dhansel/ArduinoFDC/(threads)

Thread 1 (2021-04-06):

Extension for HD possible?

Scotty42, 2021-04-06:
I was wondering if hardcoded gaps, sectors, etc or the required data rate of 500 kbit vs. 250 kbit is the actual limiting factor that blocks high density (1,2 MB + 1,44 MB) support?

dhansel, 2021-04-13:
The limiting factor is the data rate. At 500 kbit, a new data bit
arrives from the drive every 2 microseconds. At 16MHz clock frequency
that's only 32 processor cycles. The current read/write implementation
in C using timers is not fast enough for that.

I am considering rewriting the read/write code in assembly which
would make it possible ensure correct timing by adding up the processor
cycles needed for each instruction. That should be fast enough.

Scotty42, 2021-04-13:
Was expecting this. Thanks for clarification.

dhansel, 2021-04-18:
As expected, re-writing the read/write routines in assembly solved the timing issues
for HD disks. Timing is close but works as far as I can tell from my testing.

The controller now supports 3.5" and 5.25" DD and HD disks.

Scotty42, 2021-04-19:
That's awesome! I'll do some tests and report back.

Scotty42, 2021-04-20:
Did connect 3,5" HD as A and 5,25" HD as B on a standard floppy cable with twist on A. Host end of the cable connected to some pinheaders and an Arduino Uno board. Although I can verify Arduino pins are connected to the floppy ports according to README table, I fail to read/write/format anything. I can select s 0/1 and turn motor 0/1. Any other operations start motors, light up LEDs but nothing actually happens. Head does not step. Do you have any idea to further analyze and debug?

dhansel, 2021-04-21:
I just tried it again here, uploaded the code from GIT to the Arduino and re-connected my drive
following the wiring from the instructions. Works fine for me in that configuration (tested two different
drives). So at least the wiring/code is not completely broken :)

Do you get any error message when trying to read a sector ("r 0 1")? If so, what is the error number?
If not, does the disk LED come on when trying to read? Does it stay on and the process just hangs
or does the LED go off again? Is there any out in the terminal? try un-commenting the "#define DEBUG"
statement in ArduinoFDC.cpp and uploading again. Does that show any more information?

Try and add the following code at the end of the AduinoFDCClass::begin() function in ArduinoFDC.cpp:
```
  digitalWriteOC(PIN_SELECTA, LOW);
  step_to_track0();
  step_tracks(m_driveType[0], 20);
  step_to_track0();
  digitalWriteOC(PIN_SELECTA, HIGH);

```
After uploading you should hear the drive head step (to track 0, then track 20, then back to 0).
If that does not happen then most likely something is wrong with the wiring. Maybe the GND
signal is not properly connected? I've seen drives/cables where not all odd-numbered pins are
actually connected to ground.

Generally the code is not supposed to hang. Even with no drive connected at all it should at least
display an error message. If the code is hanging when reading, try putting a `return S_OK;`
statement at the beginning of function "read_data" in ArduinoFDC.cpp
That will skip all read attempts completely. Does that still hang? If not then that may indicate
that the code is getting stuck in the assembly section(s).

Scotty42, 2021-04-21:
I wasn't doubting your tests :). Really appreciate above tipps 👍
As almost always after reaching out to someone, problem solves itself. No, not on itself, but I can trace it back to a faulty head DIR line in the cable and some weird behavior with GND connections. I had:

- all connected
- one
- two as Arduino Uno offers 2 GND pins

And after randomly (re)selecting 2 GND pins finally a 3,5" Floppy was accessible. Haven't yet tried 5,25" again, but I'd say it is save to assume it will work now, too.

dhansel, 2021-04-21:
Glad to hear it's working! When trying the 5.25" drive make sure to set the correct drive type, either by changing
the parameters to the ArduinoFDC.begin() function or by using the 't' command.

Scotty42, 2021-04-21:
I can confirm 5,25" HD drive working with HD floppy and mode t2.
I fail to r/w/f a DD floppy though. r/w yields error No sync marks found! and f leads to some undefined operation for minutes that ends without error but does not do anything.

dhansel, 2021-04-21:
Does the head step while trying to format the DD disk The format process does not read anything back to see whether the format worked. It just formats a track and moves on to the next. So 'f' returning OK doesn't really mean much.

I assume you mean you're having problems with a 5.25" DD disk. Which disk type are you setting? Since you have a 5.25DD
disk in a HD drive you need type 1 (5.25DDonHD). Also make sure to read the README section about the DENSITY
pin. Also note that you need a true 5.25" DD disk. You can try and format a HD disk as DD but that does not always work.

Thanks for the correction on the "t" command help. I'll fix that. The proper order is:
0=5.25DD / 1=5.25DDonHD / 2=5.25HD / 3=3.5DD / 4=3.5HD

Scotty42, 2021-04-21:
yes, I was testing a real DS/DD floppy with 48TPI and setting t := 1. I'm fortunately mature enough for having used all sorts of floppies in real live, not only nowadays for retro reminiscent feelings or curiosity :).
The floppies tested had been formatted in one of my classic PC gear and actually even on the drive I momentarily use for this Arduino project.
Head steps from track 0..max during format. Resets back to 0 to write DOS sector but does not write anything to the disk.

dhansel, 2021-04-21:
I think the problem is that the density pin mode doesn't get automatically switched when you change
drive types via the 't' command. Try replacing `setDensityPin();` with `setDensityPinMode((type==DT_3_HD || type==DT_3_DD) ? DP_DISCONNECT : DP_OUTPUT_LOW_FOR_DD);` in the ArduinoFDCClass::setDriveType() function.
Note: I can't try this myself right now so hopefully I didn't make any typos.

Scotty42, 2021-04-21:
will give it a shot. Figured already between
`#if defined(PIN_DENSITY)
  // by default: 3.5"  drives do not use DENSITY pin (disconnect)
  //             5.25" drives expect DENSITY to be LOW for low density
  m_densityPinMode[0] = (m_driveType[0]==DT_3_HD || m_driveType[0]==DT_3_DD) ? DP_DISCONNECT : DP_OUTPUT_LOW_FOR_DD;
  m_densityPinMode[1] = (m_driveType[1]==DT_3_HD || m_driveType[1]==DT_3_DD) ? DP_DISCONNECT : DP_OUTPUT_LOW_FOR_DD;
  digitalWrite(PIN_DENSITY,   LOW);
  pinMode(PIN_DENSITY,   INPUT);
#endif`
initialization and later
`void ArduinoFDCClass::setDensityPin()
{
#if defined(PIN_DENSITY)
  byte isHD = m_driveType[m_currentDrive]==DT_3_HD || m_driveType[m_currentDrive]==DT_5_HD;
  switch( m_densityPinMode[m_currentDrive] )
    {
    case DP_OUTPUT_LOW_FOR_DD:
      digitalWriteOC(PIN_DENSITY, isHD ? HIGH : LOW);
      break;

    case DP_OUTPUT_LOW_FOR_HD:
      digitalWriteOC(PIN_DENSITY, isHD ? LOW : HIGH);
      break;

    default:
      digitalWriteOC(PIN_DENSITY, HIGH);
    }
#endif
}`
in fact nothing changed by type setting. So default is LOW. For my TEAC 55GFR on the test bench that is HD so the reason it works for HD per default is clear

dhansel, 2021-04-21:
I'm also using a TEAC 55GFR here, so chances are good that you should be able to get it to work.
I'm not following 100% what you mean by "default is LOW". If the DENSITY pin is not connected then
it defaults to HIGH (via the pullup resistor). In its default configuration, the 55GFR expects the DENSITY
pin to be HIGH (or unconnected) for high density and LOW (pulled to GND) for low density.
You can find a user manual for the 55GFR [here](https://github.com/dhansel/Altair8800-IOBus/blob/main/04-disk-controller/doc/TEAC%20FD-55GFR.pdf).

Scotty42, 2021-04-21:
was a typo. Already corrected in the comment. default is HIGH.
With the change t1 => LOW and t2 => HIGH on PIN2. Still no positive result for DD disks.
HD works flawlessly and still works after the change.

```
Command: r 0,1,0
Reading track 0 sector 1 side 0
Error: Sector header not found!
```

or

```
Command: r 0,1,0
Reading track 0 sector 1 side 0
Error: No sync marks found!
```

dhansel, 2021-04-21:
I understand now, thanks.. We're both saying the same thing. Weird that it still won't work. I'll give it another
try here later tonight.

dhansel, 2021-04-22:
I think I know what the issue is: the drive rotation rate. Original 5.25" DD drives rotated at 300 RPM. When HD drives came around, the rate was  increased to 360 RPM. When you have a DD disk in an HD drive then you have two possibilities:
1. Use the slow 300 RPM rotation rate and a data rate of 250 kbps (just like an original DD drive).
2. Use the fast 360 RPM rotation rate and an increased data rate of 300 kbps.

Both will cause the disk to rotate under the head for the same amount of physical space for each data bit read/written.

Regular floppy disk controllers generally use option (2). So when you have the drive connected to your computer, the controller there will expect the drive to always rotate at 360 RPM and adjust its data rate. to 300 kbps.

My code currently is set up to use a data rate of 250kbps for DD, requiring the drive to switch to 300 RPM in DD mode. I remember now that I set up my drive to do that (when I first started working with 5.25" DD disks in the 55GFR).

However, it should be pretty simple to fix the code: Just change the "32" to "27" in line 55 (the bitLength field of the drive geometry structure for the DT_5_DDonHD drive type).  That will change the bit rate for that type. Note that 27 is not quite the correct value, it should be 26.6666... - but processor cycles are atomic so I can't make it more precise. The timing will be off by 1.25% which should be ok - as far as I know the drive rotation speed itself has a tolerance of about 3%.

I've done some tests here with that timing on DD and have not had any problems reading or writing.

Alternatively, you can re-configure your 55GFR to switch to 300 RPM in DD mode by removing the "II" strap (which is set by default) and moving it to "IS". That will cause the drive to slow its rotation to 300 RPM when the "density" signal goes low. You can find more info on that on page 133 of the 55GFR manual I linked to before.

Scotty42, 2021-04-22:
I was reviewing gaps and geometry yesterday evening with data from [http://www.moria.de/~michael/floppy/floppy.ps](url) but couldn't find an issue; I had been expecting timing issues and thought gaps would directly relate.
Anyway, changing the bit length did the trick. DD in HD drive works 👍

dhansel, 2021-04-23:
Great to hear it's all working now. Let me know if you find more problems.
FYI - I have applied the fixes for the 5.25" DD disks in HD drives to the repository. For the rotation rate issue, the code
now measures the rotation rate and automatically uses the corresponding data rate.

Scotty42, 2021-04-23:
Actually I found two things yesterday. Firstly parameter order for read and write seem not identical t/s/h vs t/h/s. Secondly a DD disk is not really writeable with a floppy controller and another drive. Tested with a 386. Dir listing works but as soon as some data is written, write errors pop up. Timing seems to remain critical. But that was already a problem in the days when DD written on a HD drive were exchanged

dhansel, 2021-04-23:
I took a look at the code (and tried reading/writing here) and as far as I can see both read ('r') and write ('w') commands use t/h/s
for the parameter order. What makes you think the order is different?

Regarding writing DD in another drive: Are you saying that a DD disk formatted using ArduinoFDC is not readable on a different controller and drive? Is the other drive a true DD drive or an HD drive? It is a general problem that a DD disk written (or formatted) in a HD drive can often not properly be read in a DD drive. That's because the HD head is smaller than a DD head and the magnetization can be too weak for the DD head to consistently detect.  Since writing to a disk also involves reading (to find the sector), the problem may actually be a read error due to this effect. If this is the cause then I don't think anything can be done - it's a hardware issue. As you say, writing to a DD disk in a HD drive has always caused problems.

Scotty42, 2021-04-24:
Nevermind, it was late. Functions are consistent in their respective context. But not in-between for easy comparison. Like writing boot sector                   `ArduinoFDC.writeSector(0, 0, 1, data, false);` and reading it according to serial menu r 0,1,0.

I know the technical limitations of HD and DD drives. No worries. Therefore I meant exactly the scenario of reading and writing a formatted DD floppy, formatted in mentioned HD drive, and then writing to it in a real computer's HD drive. Which I think is either Panasonic brand or Teac, too. That doesn't work without errors.

dhansel, 2021-04-25:
I did a bunch of testing this weekend but was not able to reproduce the problem with writing DD disks. All 5.25" DD disks formatted by ArduinoFDC were  always readable and writable on a Win98/DOS machine. However, I only have one 5.25" drive so I can't exactly reproduce your setup.

Two things come to mind that you may want to try (if you haven't already).

1. Maybe the problem is with the FAT file system initialized by ArduinoFDC rather than the low-level format. You could try formatting a disk with ArduinoFDC, then format it again on the DOS computer with a "/q" argument to ONLY reset the filesystem. If writing works after that then that would indicate that the file system (rather than the low-level format) is the problem.
2. It is possible (though unlikely) that the 1.25% timing difference with the 300kbps data rate is causing a problem. Again, I was not able to reproduce that but who knows. You could try changing the straps on your 55GFR to have it switch to 300RPM for DD mode. The latest versions of ArduinoFDC automatically determine the data rate and for 300RPM will use the precise 250kbps data rate instead.

Anyways, let me know if you find anything else.

BTW - I just added support for directly reading/writing files on a FAT file system as well as the possibility to transfer full disk images and single files via XModem.

Scotty42, 2021-04-27:
Actually found some time now to re-test using the latests code. Impressive development in-between the two versions.
I was going with your scenario 2, because I used two different drives, both with tolerances.

Good news is, with latest code, I could not reproduce the error. A 5,25" DD could be formatted with Arduino, read and written by DOS (tried to sys it which worked flawlessly). Then I changed drives back, wrote a test file with ArduoDOS, which I then edited with Norton Commander on that DOS machine.

Closed 2021-04-13.

Thread 2 (2021-05-06):

USB mass storage Uniform Floppy Interface device class

VasylSamoilov, 2021-05-06:
Can it be used as usb floppy controller (implement UMS UFI device class)? There is no USB controllers for 5.25, and never were, and this may be a chance to connect 5.25 floppy to modern PC via USB :)

dhansel, 2021-05-06:
Neither the Arduino UNO nor the Mega have the capability to act as anything other than a serial-over-USB device. As far as I know all Arduinos or other devices that are capable of more generic USB handling use a different processor architecture so would require rewriting large portions of the code (the critical parts are implemented directly in processor-specific assembly language).

So I don't think this can be converted directly into a usb floppy controller. You could implement the USB communication part on a different device and then talk to the Arduino via serial the serial connection to read/write data on the disk.

VasylSamoilov, 2021-05-07:
Most unofficial Uno and Mega boards probably can't, as they use CH340G as USB-to-Serial converter. But those Arduino that has a USB connection in the main MCU, like Leonardo, Micro, Pro Micro, Due, Zero and LilyPad USB can probably use https://github.com/Palatis/Arduino-Lufa (port of Lightweight USB Framework for AVRs), which includes USB mass storage class.

dhansel, 2021-05-07:
True but as I said the ones that have USB support in their main MCU are using a different MCU so I don't know
if my code will run on them since it is highly optimized for the Atmega328p. Apart from the Due (on which it
definitely doesn't work) I don't have any of them so I can't test it here.

Pablo2048, 2021-05-07:
Maybe we can use Arduino Micro Pro - uses Atmega32Ux - AVR core, compatible with Atmega328p AFAIK...

dhansel, 2021-05-07:
I checked out the Micro Pro/Atmega32Ux and that does look promising. I'll get one and check out
if the ArduinoFDC library works on it. I'll leave figuring out the USB protocol to someone else though...

Closed 2021-05-07.

Thread 3 (2021-05-06):

Compile error

rtrimbler, 2021-05-06:
Not sure how you are building this project, but with Arduino IDE 1.8.13, I could not get the code to compile.
Getting an error here:

file: ArduinoFDC.ino
line 227: void print_ff_error(FRESULT fr)
error: FRESULT not declared in this scope

With enough searching the web, I finally figured out it doesn't deal well with the typedef enum as a variable type. Had to add a forward reference just ahead of this line and all is well:

void print_ff_error(FRESULT fr);

Other than that, it seems to be working OK. I've only tried it with a Teac FD-235 hf drive and a 3.5" DD disk. I can format & r/w in the monitor; re-formatted in ArduDOS & created a couple of directories. Oddly, putting this disk into a USB floppy drive on Win10 still reads the original directory (albeit very hesitantly.)

Great project, thanks for sharing! My goal is to try and read some old 1.2M (HD?) 5.25" floppies. I do have a teac fd-55gfr, but can't find the ribbon cable with the card edge connector for it.

-- RT

Jorin-Post, 2021-05-06:
Hello,

I'm not sure but try to change void print_ff_error(FRESULT fr) to void print_ff_error(&FRESULT fr)
If you want to sent data back to the previous function & will change the incoming data to the new data if the data is finished.
success not guaranteed ;p

-- jorin

rtrimbler, 2021-05-06:
Success certainly isn't guaranteed with that - the syntax is wrong. void print_ff_error(FRESULT &fr) would in fact pass fr by reference, but that's not what's needed here. print_ff_error has no need to modify fr and the calling function wouldn't expect it to. I already had success with my suggestion; just not sure why it never showed up for you. Seems like this is a known problem with how the arduino IDE builds the .cpp file it passes off to the compiler.

dhansel, 2021-05-06:
Very strange - I use the same Arduino IDE version (1.8.13) and have no problem compiling. I tried re-downloading everything from GitHub but that compiled fine too.

What platform are you on (Windows/Linux/Mac)? I am on Windows. Maybe that makes a difference.

Can you let me know where exactly (line number) you inserted the forward declaration? Then I can just put it there for safety (can't hurt). But since I can't reproduce the problem here I need to know exactly where to put it,

Thanks for reporting this!

rtrimbler, 2021-05-07:
I am using Win10 as well, so that's pretty strange behavior. I think arduino uses a version of GCC though, and I don't have anything else loaded that may have updated that.

I literally put the forward declaration 1 line before the formal declaration. So on the latest code I found on github, the forward decl is on line 227 and the actual function is now on line 229 (I like white-space.)

dhansel, 2021-05-07:
Ok I added the declaration. Hopefully it will save someone from having to deal with the compile error you encountered.
Thanks again!

rtrimbler, 2021-05-07:
Looks good!
2nd problem - I've tried several disks, both DD and HD (all 3.5") that read fine on a windows/usb floppy, but this project won't read any sector/head for tracks 0 & 1.
It reports this (with #DEBUG enabled)
Command: r 0,1,0
Reading track 0 sector 1 side 0
Unable to find header!
Unable to find header!
Error: Sector header not found!

Tracks 2-79 read fine. Of course, without the first couple of tracks ArduDOS can't see any directory. Any ideas?

rtrimbler, 2021-05-07:
Sorry for the delay.  My code was somewhat different than the base b/c I changed the pins to make wiring easier on myself. Spent the morning trying to figure out why your debug info wasn't appearing; then realized I had patched incorrectly. Here is the output. I read a sector from track 2 first (which works) then from track 0.

```
Drive A: 3.5" HD
Drive B: 3.5" HD

Command: r 2,1,0
Reading track 2 sector 1 side 0
HFE02001202+
HFB82023930-
0000: 30 30 30 20 49 6E 74 65  6C 20 43 6F 72 70 6F 72   000 Inte l Corpor
0010: 61 74 69 6F 6E 0D 0A 0D  0A 3B 20 2A 2A 2A 2A 2A   ation... .; *****
0020: 2A 2A 2A 2A 2A 2A 2A 2A  2A 2A 2A 2A 2A 2A 2A 2A   ******** ********
0030: 2A 2A 2A 2A 2A 2A 2A 2A  2A 2A 2A 2A 2A 2A 2A 2A   ******** ********
0040: 2A 2A 2A 2A 2A 2A 2A 2A  2A 2A 2A 2A 2A 2A 2A 2A   ******** ********
0050: 2A 2A 2A 2A 2A 2A 2A 0D  0A 3B 20 49 6E 74 65 6C   *******. .; Intel
0060: 20 69 73 20 6D 61 6B 69  6E 67 20 6E 6F 20 63 6C    is maki ng no cl
0070: 61 69 6D 73 20 6F 66 20  75 73 61 62 69 6C 69 74   aims of  usabilit
0080: 79 2C 20 65 66 66 69 63  61 63 79 20 6F 72 20 0D   y, effic acy or .
0090: 0A 3B 20 77 61 72 72 61  6E 74 79 2E 20 20 0D 0A   .; warra nty.  ..
00A0: 3B 20 2A 2A 2A 2A 2A 2A  2A 2A 2A 2A 2A 2A 2A 2A   ; ****** ********
00B0: 2A 2A 2A 2A 2A 2A 2A 2A  2A 2A 2A 2A 2A 2A 2A 2A   ******** ********
00C0: 2A 2A 2A 2A 2A 2A 2A 2A  2A 2A 2A 2A 2A 2A 2A 2A   ******** ********
00D0: 2A 2A 2A 2A 2A 2A 2A 2A  2A 2A 2A 2A 2A 2A 0D 0A   ******** ******..
00E0: 3B 20 49 6E 66 6F 72 6D  61 74 69 6F 6E 20 69 6E   ; Inform ation in
00F0: 20 74 68 69 73 20 64 6F  63 75 6D 65 6E 74 20 69    this do cument i
0100: 73 20 70 72 6F 76 69 64  65 64 20 69 6E 20 63 6F   s provid ed in co
0110: 6E 6E 65 63 74 69 6F 6E  20 77 69 74 68 20 0D 0A   nnection  with ..
0120: 3B 20 49 6E 74 65 6C 20  70 72 6F 64 75 63 74 73   ; Intel  products
0130: 2E 20 20 4E 6F 20 6C 69  63 65 6E 73 65 2C 20 65   .  No li cense, e
0140: 78 70 72 65 73 73 20 6F  72 20 69 6D 70 6C 69 65   xpress o r implie
0150: 64 2C 20 62 79 20 65 73  74 6F 70 70 65 6C 20 0D   d, by es toppel .
0160: 0A 3B 20 6F 72 20 6F 74  68 65 72 77 69 73 65 2C   .; or ot herwise,
0170: 20 74 6F 20 61 6E 79 20  69 6E 74 65 6C 6C 65 63    to any  intellec
0180: 74 75 61 6C 20 70 72 6F  70 65 72 74 79 20 72 69   tual pro perty ri
0190: 67 68 74 73 20 69 73 20  67 72 61 6E 74 65 64 20   ghts is  granted
01A0: 0D 0A 3B 20 62 79 20 74  68 69 73 20 64 6F 63 75   ..; by t his docu
01B0: 6D 65 6E 74 2E 20 20 49  6E 74 65 6C 20 61 73 73   ment.  I ntel ass
01C0: 75 6D 65 73 20 6E 6F 20  6C 69 61 62 69 6C 69 74   umes no  liabilit
01D0: 79 20 77 68 61 74 73 6F  65 76 65 72 2C 20 0D 0A   y whatso ever, ..
01E0: 3B 20 61 6E 64 20 49 6E  74 65 6C 20 64 69 73 63   ; and In tel disc
01F0: 6C 61 69 6D 73 20 61 6E  79 20 65 78 70 72 65 73   laims an y expres

Command: r 0,1,0
Reading track 0 sector 1 side 0
HFE02000702+
HFB005F0032-
HFE02000802+
HFB311F301D-
HFE02000902+
HFB003081C3-
HFE02000A02+
HFE02000B02+
HFE02000C02+
HFE02000D02+
HFE02000E02+
HFE02000F02+
HFE02001002+
HFE02001102+
HFE02001202+
HFE02000D02+
HFB0E566572-
HFE02000E02+
HFB5A7A657B-
HFE02000F02+
HFB20436F72-
HFE02001002+
HFE02001102+
HFE02001202+
HFE02000102+
HFE02000202+
HFE02000302+
HFE02000402+
HFE02000502+
HFE02000602+
HFE02000702+
HFE02000802+
HFE02000902+
HFE02000A02+
HFE02000B02+
HFE02000C02+
HFE02000D02+
HFE02000E02+
HFE02000F02+
HFE02001002+
HFE02001102+
HFE02001202+
HFE02000102+
HFE02000202+
HFE02000302+
HFE02000402+
HFE02000502+
HFE02000602+
HFE02000702+
HFE02000802+
HFE02000902+
HFE02000A02+
HFE02000B02+
HFE02000C02+
HFE02000D02+
HFE02000E02+
HFE02000F02+
HFE02001002+
HFE02001102+
HFE02001202+
HFE02000102+
HFE02000202+
HFE02000302+
HFE02000402+
HFE02000502+
Unable to find header!
HFB20436F72-
HFE02001002+
HFB01A381A8-
HFE02001102+
HFB303F0603-
HFE02001202+
HFE02000102+
HFE02000202+
HFE02000302+
HFE02000402+
HFE02000502+
HFE02000602+
HFE02000702+
HFE02000802+
HFE02000902+
HFE02000A02+
HFE02000B02+
HFE02000C02+
HFE02000D02+
HFE02000E02+
HFE02000F02+
HFE02001002+
HFE02001102+
HFE02001202+
HFE02000102+
HFE02000202+
HFE02000302+
HFE02000402+
HFE02000502+
HFE02000602+
HFE02000702+
HFE02000802+
HFE02000902+
HFE02000A02+
HFE02000B02+
HFE02000C02+
HFE02000D02+
HFE02000E02+
HFE02000F02+
HFE02001002+
HFE02001102+
HFE02001202+
HFE02000102+
HFE02000202+
HFE02000302+
HFE02000402+
HFE02000502+
HFE02000602+
HFE02000702+
HFE02000802+
Unable to find header!
Error: Sector header not found!

Command:
```

dhansel, 2021-05-07:
Ok so the disk reads just fine but even after trying to step to track 0, the sector headers that are
being read still say that the drive is on track 2.

This looks to me like your drive is out of alignment and can't reach tracks 0 or 1, i.e. the "track 0"
signal goes LOW even though the drive head has not reached track 0 yet.

Do you have a different drive that you could test with?

rtrimbler, 2021-05-07:
Arrrrgggghhh. It's the hardware.  I just swapped in a different 3.5" floppy (same model Teac, but a different generation it appears) and it works **fine**. Reads all sectors; Ardudos lists a directory & everything. Curiously, the free space report is different: ArduDOS: `1373696 bytes free`, Win10: `1,372,672 bytes free`

rtrimbler, 2021-05-07:
I did find a very small error when wandering thru the code:
ArduinoFDC.cpp, line 154 says
`static struct DriveGeometryStruct geometry[6] =`
pretty sure that should be `[5]`
Doesn't really hurt anything as-is, but the compiler won't notice if you wander off the end.

dhansel, 2021-05-07:
Thanks for the correction. I fixed it in the repository.

Closed 2021-05-06.

Thread 4 (2021-12-07):

Support for old FM Formats and different Sector sizes ??

roman65536, 2021-12-07:
Is it possible to support also old FM Floppy drives (such as 8 inch) and different sector sizes such as 256,128 or 1024 byte, such as listed in https://en.wikipedia.org/wiki/List_of_floppy_disk_formats ? Nice feature would be, to find out what is the sector size by it self and recording method.

This way, also old IBM 8 Inch drive could be supported and also most of the CP/M formats.

rgds
Roman

jacobtohahn, 2022-06-13:
This would be awesome. I was just messing around with the code to see if I could get it to work with a Single Side Single Density 8" floppy drive I have, but the code assumes that the drive has two heads, whereas mine only has one. It properly moves the head along the disk when formatting but reports a low level disk error after attempting to write the filesystem. Also fails to read data in the low-level monitor (Drive Not Ready error). I'm not a coder so there's no way I could possibly modify this code to work on my own!

jacobtohahn, 2022-06-14:
A little update:
With some work, I was able to interface with the 8" drive. "Drive Not Ready" error was cased by bad diskettes (the magnetic surface was being scraped off by the head) so I dug up another box which had better diskettes and after some code modification to make some of the functions only use head 1, I can (kinda) format, read, and write.

Format has issues. The first ~38 tracks read fine after the format, but after that CRC and data checksum errors begin to appear, getting more frequent the more you read. By track 60 or so pretty much all the data fails to read. However, when writing the buffer to the entire disk, you can read MUCH more, but in the late track 60s and into the 70s the drive begins to seek back and forth and some sectors have header errors. This happens with any disk I try. Not sure if this is caused by my drive or not.

I also had to implement logic to all the write functions to drive the Low Write Current (aka TG43) line on my drive low when writing past track 43, and drive it high when writing track 43 or below. It's possible that this logic is not functioning properly, which could be causing the read issues described previously.

dhansel, 2022-06-14:
Unfortunately the write issue for higher track numbers on 8" drives is to be expected with the current implementation and is the main reason I have not added support for such drives. The problem is that when writing to the inner (higher numbered) tracks, there is less physical space to put all the data than on outer tracks. So bits sit closer together. This becomes a problem because if bits are too close together then the changes of magnetic flux get pushed apart by each other, which means that the timing is not right when reading the data back. The solution to this is called "[write precompensation](https://marc.info/?l=classiccmp&m=137609524004633)" which basically slightly changes the timing while writing such that the data looks correct when reading it back.

This is not so much a problem for 5.25" and 3" drives because (I think) the disks themselves have a much higher density in the magnetic layer so can better handle flux transitions in a small space.

Now I have implemented write precompensation in a different project (see [here](https://github.com/dhansel/Altair8800-IOBus/blob/main/04-disk-controller/Firmware-ICOM/Firmware-ICOM.ino)) which supports 8" drives. It should be technically possible to port the general idea over to ArduinoFDC but that would require re-writing a significant portion of code. It was really hard getting the timing right in the other project and I'm just not up for doing that work again here, especially since only very few people would use it. It's just not worth the effort for the very small number of people who may want to read/write 8" disks with an Arduino.

jacobtohahn, 2022-06-14:
That makes sense. Unfortunate that we won’t see an implementation here, as I don’t think many others have done something similar. I’ll look around and see if someone else has done it.

RetroAND, 2023-02-02:
> Now I have implemented write precompensation in a different project (see [here](https://github.com/dhansel/Altair8800-IOBus/blob/main/04-disk-controller/Firmware-ICOM/Firmware-ICOM.ino)) which supports 8" drives. It should be technically possible to port the general idea over to ArduinoFDC but that would require re-writing a significant portion of code. It was really hard getting the timing right in the other project and I'm just not up for doing that work again here, especially since only very few people would use it. It's just not worth the effort for the very small number of people who may want to write 8" disks with an Arduino. Note that reading existing disks works fine, only writing is affected by this.

Hello,

I am one in the "very small group of people" and for me, it's worth: I have recently acquired a S/23 Datamaster.

I understand the load of works of this kind of projects, I too have felt it. While you may not proceed, could you identify what sections would require modification so I could test it, please?

Both this and your ICOM project seem great! So thank you anyways for having left them open.

Regards

dhansel, 2023-02-02:
The hard part about implementing write pre-compensation is _very_ precise timing that it requires plus the amount of calculation necessary to know when to apply it. It's a significant change rather than a few modifications.

Other implementations (including my ICOM one) use the ATMega's SPI device to produce output at an 8 MHz rate.

First you'll have to shuffle output pins around since currently D9 is the WRITEDATA output but on the ATMega328p (Arduino Uno) D11 is the SPI output. Other supported architectures (Mega, Micro) will have different SPI pins.

The problem with using SPI on the ATMega328p is that it can't output a continuous stream of bits since it is only single-buffered. You can't queue up the next output byte while the current one is being written. You have to wait until the current SPI transfer finishes, then you can start transferring the next byte. Which means there will be a tiny gap in the data. That's fine for SPI but the data output stream to the floppy **must** be continuous. If there are gaps then the written data will be invalid.

There is a way around that (as I have done in the ICOM implementation): The MFM data written to the disk always has at least a one-microsecond period of "0" between two expected pulses. That one microsecond is one byte of SPI transfer. So if you time the output very precisely then you can initiate the next SPI byte (to output a pulse to the floppy at the precisely timed moment for write precomp) exactly at the right point during that microsecond gap so the pulse appears on the SPI output at the right moment. You can't use interrupts for that as the ATMega's interrupt latency is much to big - by the time the interrupt routine starts the microsecond window has already passed. So the only way to do this on the ATMega (that I know of) is to precisely count processor cycles while you're figuring out the next pulse to send and make sure that for all paths through the code it will end up doing the SPI output instruction at the correct time. That requires a _lot_ of work counting the cycles and structuring the code accordingly. I did the work for the ICOM FDC but really don't want to do it again here.

If you want to see the differences, compare function write_data() in ArduinoFDC.cpp with write_sector_data_dd() in the ICOM firmware as well as function format_track() in ArduinoFDC.cpp and format_track_dd() in the ICOM firmware. There are a bunch of comments in there that should explain things more.

Note that the write precompensation is only necessary when writing to track 60+ on 8" floppy disks. You can read all you want without problems and you can write (at least) the first 50 tracks without any issues using ArduinoFDC.

If you want to create disks for your S/23 I suggest you use some other project (like the GreaseWeasle) that runs on faster hardware more suited to the precise timing requirements of write precomensation.

RetroAND, 2023-02-03:
If the microcontroller had some additional hardware to queue a second byte like a  shift register such as a 74LS164 or 74LS165 directly connected to the data output while being updated by SPI clock, wouldn't that help to create a more continuous stream?

dhansel, 2023-02-03:
Not really. What is needed is the capability to queue up a new byte for transmission while the previous one is still transmitting so the new byte can be transmitted as soon as the old one is finished. I don't see how a shift register would help with that. It needs some additional logic within the microcontroller that the ATMega just doesn't have.

RetroAND, 2023-02-03:
I proposed to add a shift register because it would latch the output, therefore the problem of having that undesired zero value after every SPI transmission. But as you said, the queuing is to be made **before** serialization, therefore a shift register per se wouldn't be that useful.

While writing this I had an idea, I need to dig in some documentation this weekend.

In any case, thank you very much.

jacobtohahn, 2023-02-03:
@dhansel thank you for explaining that all! I see now why this is a very difficult implementation.

@RetroAND If you make any progress or do implement this, post an update here, because I'm still interested in using it to read/write 8" disks.

janrinze, 2023-04-29:
Bump here. I'd love to use this project for reading 5 1/4" Single Density 40 track floppies.
I haven't delved into the code yet but Single density should be doable because the pulses have a low frequency and there are always clock pulses. Not sure how this project does all the capture of the pulses but i'll have a look around.

Thread 5 (2022-05-11):

FormatDisk hangs forever

daid, 2022-05-11:
I'm encountering this issue where the formatDisk function hangs forever, and never returns from the first `format_track()` call.

It's quite a "rotten" disk that I'm using. It read track 40 if this disk. But when I tried a `formatDisk(buffer, 0, 0)` it just hangs and keeps spinning the disk forever. Reading track 0 doesn't work, which I figured it might be damaged beyond repair or just lost it's formatting. But I wouldn't expect a bad disk to cause the format to hang forever.

I'm not sure where it can hang. I know the `wait_for_index()` finishes: <https://github.com/dhansel/ArduinoFDC/blob/main/ArduinoFDC.cpp#L740> but somewhere after that it just hangs.

I'm using different pinout from default on an arduino nano. I can read/write other disks just fine. Didn't try format on any other disk, dont want to screw up any other disks that I have.

dhansel, 2022-05-11:
Did you maybe change the pin for the INDEX hole? If so you also have to update the IDXPORT and IDXBIT settings here: https://github.com/dhansel/ArduinoFDC/blob/cd3b1c0417d39498b1bb882b5a2bcb5ef93bb41c/ArduinoFDC.cpp#L51-L52

After writing the track data during format the code keeps writing filler bytes until it sees the index hole again. If you changed the INDEX pin without updating IDXPORT/IDXBIT then the assembly code will just wait forever for the index hole.

daid, 2022-05-12:
Ah, yes. I did change the index pin, but and I changed the IDXPORT, but now I see that I changed it wrong. I changed it to PC5, but made IDXPORT point to the `PORTC` register instead of the `PINC` register (most likely because is named IDX**PORT** )

Stupid mistake from my side. Thanks!

(I think there can be some way to pass these from C to assembly without needing to double define them in ASM and C, I might investigate and make a pull request)

Closed 2022-05-12.

Thread 6 (2022-05-13):

HD Floppy doesn't work without formating it in low leve disk mode

thatsitipl, 2022-05-13:
I have some old HD Floppys but when i try to run the r command it only returns something like:
Reading track 0 sector 1 side 0 => Error: No sync marks found!
After i reformat it works.

Any Help is appreciated
Best regards

dhansel, 2022-05-13:
Do you know for sure that the disks are properly formatted and readable? It is certainly possible that the magnetization on the disks has degraded over time to a point where they cannot be read anymore.  Formatting the disk then restores it to a readable (but empty) state.

If the old content of the disks is important to you then I would recommend a project like [Greaseweazle](https://decromancer.ooo/greaseweazle) or [Fluxengine](http://cowlark.com/fluxengine/index.html). These projects extract the raw flux data from the disk and use a PC (much more powerful than an Arduino) to decode it. They are much better at error correction than my ArduinoFDC project. Therefore they are much better if the goal is to read important content of old degraded floppy disks. But they only work in conjunction with a PC.

ArduinoFDC is meant for using floppy disks as a storage medium (reading and writing) using only an Arduino. It can also read old disks (I have used it successfully on 20 year old disks) but only if they have not degraded too much.

If the disks work fine after formatting then I think your setup is good and it is just the old age and degradation of the disks that is causing the problem.

thatsitipl, 2022-05-14:
Thank you very much for your response im going to check on the other projects

Closed 2022-05-14.

Thread 7 (2022-07-13):

Power connection?

zechmer, 2022-07-13:
I did not find a description of how to power the floppy drive with 12V and 5V power connections (I know that you can power it with ATX etc.). In the picture it seems that USB is used for power (aren't the 12V necessary?). Can you please add such a description? What did you use?

mchro, 2022-07-13:
@zechmer Connecting only 5V power should be enough, if not for all floppy drives then for almost all.
Pinout is pretty simple:
* Red: 5V
* Black: GND

https://en.wikipedia.org/wiki/Berg_connector

dhansel, 2022-07-13:
As far as I know 3.5" floppy drives only need 5V power but 5" drives do need 5V and 12V power. In the picture the black cable going to the left is the power cable, coming from an external hard drive power supply ([something like this](https://www.amazon.com/SATA-Adapter-Converter-Cable-Drive/dp/B01HO07GNW)) with an adapter for the smaller 3.5" drive connector.

You should be able to power a 3.5" drive directly from USB, i.e. connect the 5V and GND pins from the Arduino to the 5V and GND pins on the [floppy power connector](https://en.wikipedia.org/wiki/Berg_connector). I have done that before. Use a good USB cable from the PC to the Arduino, otherwise you will get too much voltage drop over the cable and things won't work correctly.

dhansel, 2022-07-13:
I have added a section about the power supply in the description. Thanks for the suggestion!

Closed 2022-07-13.

Thread 9 (2023-03-06):

Constantly getting Error #1: Low-level disk error

ACrazyTown, 2023-03-06:
I'm trying to read a 3.5 HD floppy disk, however I constantly get low-level disk errors in ArduDOS while trying to run `dir`.

I'm pretty sure I connected everything correctly as it can detect if a drive is inserted or not, but I don't know why I keep getting the low-level disk errors.
I don't know what could be the problem, it could be the floppy drive, maybe even the disk. Does anyone know of some troubleshooting steps I could try to pinpoint where the issue is?

dhansel, 2023-03-06:
On the ArduDOS command line, type "monitor" which will get you into the low-level disk monitor.
The disk drive motor should automatically turn on at that point. Check if it's running.
If not, type "s 1" to select drive B (maybe you have the drive wired as drive B). Does the motor run now?
If not then check your wiring. Make sure the drive has power.

If the motor runs then type "r 0,0,0" which should read the first sector on the disk. What error do you get?
Check the corresponding entry in the "Troubleshooting" table on the ArduinoFDC GitHub page.

ACrazyTown, 2023-03-06:
> On the ArduDOS command line, type "monitor" which will get you into the low-level disk monitor. The disk drive motor should automatically turn on at that point. Check if it's running. If not, type "s 1" to select drive B (maybe you have the drive wired as drive B). Does the motor run now? If not then check your wiring. Make sure the drive has power.
>
> If the motor runs then type "r 0,0,0" which should read the first sector on the disk. What error do you get? Check the corresponding entry in the "Troubleshooting" table on the ArduinoFDC GitHub page.

Yup, the motor spins. I couldn't get the command you said working (said something about invalid sector specification) but typing just "r" gave me an error "Error: No sync marks found!". I'm going to try playing around with the GND pins and also a few other floppies. Thanks for your help!

Closed 2023-04-14.

Thread 10 (2023-04-14):

Custom Format Problem

flyman02, 2023-04-14:
Good morning,
I wanted to congratulate the great work done to develop the project.
I am trying to use this project on Arduino Uno. In practice I need to read and write a floppy custom format, which uses the same rules as Fat12 but uses 10 SECTOR X Tracks and 1024 Bytes X Sector. The problem is that I modify FF_MAX_SS = 1024 in the FFconf.h (Fatfs) form, it gives me a compilation error because it uses too much memory for variables, meter at 512 does not give error.
Is it possible to streamline variables in order to recover at least 600 memory bytes? Or is it possible to force the size of 1024 bytes x senctor?
The format I am trying to read is of an Gem S2 musical keyboard and the disc is 1.63MB 3.5 "HD
Thank you
FLY

dhansel, 2023-04-14:
FatFS allocates **two** blocks of memory of size FF_MAX_SS for each open file - one that holds information about where on disk the file's sectors are located and one to hold actual sector data of the file. Since the Uno only has 2048 bytes of RAM, holding two buffers of size 1024 (plus even a minimum amount of other variables) is not possible.

However, FatFS has an option FF_FS_TINY (in ffconf.h). If that is set to "1" then FatFS only allocates **one** block of memory of size FF_MAX_SS - which will make it fit into Uno RAM constraints. The downside is that now FatFS has to return the head to track 0 after reading each sector to read the information (again) on where to find the next sector. Very inefficient when reading larger files. A better way to handle this would probably be to use an Arduino Mega which has 6k of RAM.

Also note that the sector size of 512 bytes is (somewhat) hard-coded in ArduinoFDC.cpp, mostly in functions readSector and writeSector. Search for "513", "514" and "515" and replace with 1025, 1026 and 1027 respectively. The 512 sector size is also hard-coded in format_track and a bit harder to change there. But hopefully you won't have to format disks in that format.

Finally, you should probably set both FF_MAX_SS and FF_MIN_SS to 1024 since if the two are not the same then FatFS expects function disk_ioctl (in file diskio.cpp) to figure out the actual sector size for the currently inserted disk.

Note that I haven't tried this here so I don't know if there are other issues with changing the sector size.

flyman02, 2023-04-17:
I tried to modify Re FF_FS_INY and not give more error of lack of RAM, but also by changing the variables "513", "514" and "515", always formatted at 512byte per Sector. I tried to search in the various files includes all the 512 items and replace them with 1024, but always form at 512byte. Perhaps it is a limit of the floppy unit.

dhansel, 2023-04-17:
As I mentioned in my previous message, the changes I suggested are only for reading and writing. Changing the
format_track function is harder because it will involve a number of changes to set the proper size in the id record,
write the proper number of data bytes and the corresponding data checksum. All of which is currently hard-coded.

GSoftwareDevelopment, 2023-09-25:
I wanted to join the topic :) and expand on the issue of formatting with different sector sizes.

You write that it is more complicated because some of the information is hardwired in, i.e. sector size. This is pre-calculated before starting formatting:
```
      *ptr++ = 0xFE; // ID mark
      *ptr++ = track; // cylinder number
      *ptr++ = side; // side number
      *ptr++ = sectorOrder[i]; // sector number
      *ptr++ = 2; // sector length <--- this line
      uint16_t crc = calc_crc(ptr-5, 5);
      *ptr++ = crc / 256; // CRC
      *ptr++ = crc & 255; // CRC
      *ptr++ = 0x4E; // first byte of post-data gap
```
The checksum for the header is also calculated here.

And in the single track formatting routine (assembler code).
```
          ldi r26, 0" // write 2*256+0 = 512 bytes
          ldi r27, 2 `n
```

Here is my question. How to retrieve the sector size in assembler code from this array? Sorry, but I don't know how to in the ATMEL assembler.
Or more simply:
Is it enough just to change in the assembler lines the values passed to the registers (r26, r27)?

I also have technical questions :)
Can the sector size be completely arbitrary?
Does it convert linearly to the number of sectors on the path? e.g., 256 bytes is 36 sectors; 128 bytes is 72?
How can you detect the number of tracks on a floppy disk?

Sorry for the number of questions, I want to understand :)

dhansel, 2023-09-25:
It's been a while since I looked at this code or thought about floppy disk formats so take this with a grain of salt.

It should be much easier to pass the byte count high byte (2 for 512 bytes or 1 for 256 bytes) into r27 than trying to read it from the pre-computed buffer. You can't pass anything into r26 because that register is clobbered (changed) in the code before writing the data bytes. But you don't need it since the sector size should be a multiple of 256 anyways. Look at line [1080](https://github.com/dhansel/ArduinoFDC/blob/f7f121ec505fd7575e009ff334ca09c5e8b585cb/ArduinoFDC.cpp#L1080) to see how to pass data into the assembly code. You should be able to directly say "r27" to tell the compiler to use that specific register instead of just saying "r" and letting the compiler pick one.

The sector size could be made arbitrary. I think it already is for the read/write sector functions. For the format_track function you'd just have to use another register input to the assembly code to pass in the low byte count. Of course that then doesn't match the IBM format since the sector header only stores the high byte (1, 2 or 4) for the sector size.

The format routine doesn't do any calculations to figure out how many sectors will fit. It just writes as many sectors as you told it to. If it is too many then the last sectors will overwrite the first ones. The calculation is not exactly linear because there are gaps between the ID records and data record. So the gap lengths play a role in the computation of how many sectors you can fit. It is advisable to leave a longer gap at the end of the track to account for disk drives spinning at slightly different rates. If the drive is a bit slow and you don't have enough of a buffer (gap) at the end then you'll overwrite the first sector.

As far as I remember there is no way to know how many tracks there are on a disk. At least in the IBM format that information is not stored on the disk and there is no way (that I know of) to query a disk drive what it is capable of. A controller bases the number of tracks on the format that the drive and controller were designed for. You could of course just try and read starting at track 0 and see how many formatted tracks there are. When formatting, you just have to know how many tracks will fit on the disk. That depends on the disk drive itself and is usually either a maximum of 40 or 80. But many formats use fewer tracks (e.g. 35 or 76).

GSoftwareDevelopment, 2023-09-25:
You wrote:
---
It should be much easier to pass the byte count high byte (2 for 512 bytes or 1 for 256 bytes) into r27 than trying to read it from the pre-computed buffer.
---

So I understand that it is better to do separate formatting routines for sectors 128, 256 and 512 bytes? I will honestly say that I was about to do just that :) Although this is the simplest solution and a bit suboptimal in terms of memory occupation, but.... I take it as a last resort.

---
But you don't need it since the sector size should be a multiple of 256 anyways.
---

That's what I understand, you can't create sectors smaller than 256 bytes, yes? or is it just because the value `0` (zero) is written to the `r26` register and hence a multiple of 256? So to put it in simpler terms. If I do this: (we are talking about a hard code) ``` ldi r26, 128 ldi r27, 0 ``` This will create a 128 byte sector for me?

---

Regarding the number of sectors (relatively their size), does the parameter describing the bit length `m_bitLength` make a difference? What happens if I format the path, e.g. for 256 bytes/sector, but read it with the procedure for 512? :) Will it read it over those 128, giving rubbish, or will it come out with an error? And similarly with a write, where the sector is 256 bytes and I try to write 512 to it? :)

---

I noticed that there is one byte of the sector block that seems to be a purely software issue. It refers to the null byte of the buffer array - its value is `$FD`. When reading, it is compared, so I understand that its value is only related to format compatibility for PC/IBM? Can I put a different value in its place? Obviously following the rule where I check it on reading, or ignoring it? ;) I thought I could use this byte to put in simple floppy disk format information. Using a suitable arrangement of bits, I could include information about: number of tracks, number of sectors on a track, sector size or even, use of two sides of the floppy disk. :)

---

Regarding checking the number of tracks available. That's what I assumed, that there is rather no one method for that. I was even thinking myself, that when a new disk is inserted - the flag you mentioned and pin 34 :) will be set - then it checks the first two tracks. Why two? I'm only assuming a 40 and 80 track layout, and consequently, when I format for example for 40, I format the unused track with zeros alone - I even set the CRC to zero to get a physical error as a result of reading it. Then, checking these two tracks will give me the answer whether I'm dealing with a 40 or 80 track floppy. correct me if I'm wrong. :) Of course, the above argument about checking the number of tracks could be ignored when it would be possible to put the information in `buffer[0]` when writing :)

---

Anyway, I think the project is really interestingly done and I also wanted to thank you for your support - I appreciate it.

dhansel, 2023-09-25:
> So I understand that it is better to do separate formatting routines for sectors 128, 256 and 512 bytes?

What I was trying to say is that you can still use just the one formatting routine but change line 1080 such that the proper value is set for r27, i.e. add ',"r27"(bytesHi)' to line 1080 where bytesHi is a uint8 variable in C that contains either 1 for 256 bytes or 2 for 512 bytes.

Creating multiple copies of the format code will take up a lot of code space on the Arduino UNO. If I remember correctly, my ArduDOS sketch was already getting close to the limit.

> That's what I understand, you can't create sectors smaller than 256 bytes, yes?

You _can_ create smaller sectors (with the method you are describing). But of course if you hard-code 128 bytes/sector then you can't create other sizes anymore. So it would be better to pass both the low and high byte counts for the sector length from C into the assembly code (similar to what I described above). Making these changes will require learning more about the ATMEL assembler and it's interface to C code.

> I noticed that there is one byte of the sector block that seems to be a purely software issue. It refers to the first byte of the buffer array buffer[0]. [...]. Can I put a different value in its place?

That first byte (in the IBM disk format) is a marker for whether the following block is a sector id header (0xFE) or sector data (0xFB). It's used in a couple places in the code to identify what's being read so you'll have to take care when changing it. Otherwise the code might not find any sectors anymore.

Of course as with all the changes you are proposing, this deviates from the IBM format so other drives won't be able to read data or work with the disk.

> Regarding checking the number of tracks available

You could do what you propose but keep in mind that some floppy drives physically only have 40 tracks. If your drive only supports 40 tracks then it won't work. But that only applies to older (DD - double density) drives. Also, writing a disk on a 80-track drive and then trying to read the data from a 40-track drive can lead to read errors because the 80-track drive's head is smaller than the 40-track drive head. But as long as you are only working with "modern" HD (high density) 80-track drives it shouldn't be a problem.

GSoftwareDevelopment, 2023-09-25:
> add ', "r27"(bytesHi)' to line 1080 where bytesHi is a uint8 variable in C that contains either 1 for 256 bytes or 2 for 512 bytes.

The original represents:
```
     : "r"(bitlen), "r"(numsec), "r"(datagaplen), "z"(buffer), // inputs (z=r30/r31)
     : "r16", "r17", "r18", "r19", "r20", "r21", "r26", "r27"); // clobbers
```

I entered according to what you specified:
```
     : "r"(bitlen), "r"(numsec), "r"(datagaplen), "z"(buffer), "r27"(bytesHi) // inputs (z=r30/r31)
     : "r16", "r17", "r18", "r19", "r20", "r21", "r26", "r27"); // clobbers
```
and I changed the function header to:
```
static byte format_track(byte *buffer, byte driveType, byte bitlen, byte track, byte side, byte bytesHi=2)
```
However, I get an error:
```
/home/pebe/Arduino/ArduFDD2SIO/ArduinoFDC.cpp: In function 'byte format_track(byte*, byte, byte, byte, byte, byte, byte)':
/home/pebe/Arduino/ArduFDD2SIO/ArduinoFDC.cpp:1090:63: error: matching constraint references invalid operand number
      : "r16", "r17", "r18", "r19", "r20", "r21", "r26", "r27"); // clobbers
                                                               ^
/home/pebe/Arduino/ArduFDD2SIO/ArduinoFDC.cpp:1090:63: error: matching constraint references invalid operand number
```

However, when I change - which is probably wrong - to:
```
     : "r"(bitlen), "r"(numsec), "r"(datagaplen), "z"(buffer), "r"(bytesHi) // inputs (z=r30/r31)
     : "r16", "r17", "r18", "r19", "r20", "r21", "r26", "r27"); // clobbers
```
The compilation passes, but I have absolutely no idea if it is right.

Sorry, the ATMEL assembler in the C implementation is magic to me.

> Creating multiple copies of the format code will take up a lot of code space on the Arduino UNO. If I remember correctly, my ArduDOS sketch was already getting close to the limit.

Yes, I realize this is memory-inefficient - I mentioned it :)
I do not use anything more than the ArduinoFDC class, so this memory I have "some" at my disposal. :)

> You can create smaller sectors (...) will require learning more about the ATMEL assembler and it's interface to C code.

Heh... maybe by the method of deduction I can figure something out ;)
Theoretically, I could elaborate a bit on the meaning of the extra parameter in the function `format_track(...byte bytesHi=2)` When `bytesHi` would point to a value of 1 or 2, it would mean sectors 256 and 512 - that is, the MSB byte would be set. However, if its value was 128, only the LSB byte would be set, and the MSB byte would be zero :)
Heh, I know how to do it for 6502 processor ;)
```
   lda bytesHi  // get value of bytesHi to Accu (equivalent of r27)
   bmi set128   // branch if N flag set (7 bit) if Accu equals 128 or more then jump
   tax          // transfer Accu to X-Register
   ldy #0       // Y-Register equals 0
   beq set      // branch if Z flag set (Zero) Always jump becouse Y-Reg is equal 0 - faster & shorter than JMP

set128:
   tay          // transfer Accu to Y-Register
   ldx #0       // X-Register equals 0

set:
// at this point we already have in X and Y registers respectively MSB & LSB of sector size :)
```

In general, I want to use only 3.5" MF2HD 1.44MB floppy disks. Not being able to read them after reformatting in a PC, will even be advisable, since the media will be compatible only with the Atari and its systems (there are some :P)
Currently, it already cooperates with the Atari computer ([video - I'm "ranting" a bit in Polish, but don't worry :D](https://youtu.be/Sb_v3agI8cY?si=u-CLXlFdILXlqxNg&t=328) ), however, this cooperation is at a very basic level. The maximum capacity of the floppy disk is not used. No write optimization - a sector of 128 bytes written in 512 bytes....
But thanks to your help, and others from the ranks of retro geeks, the project is moving forward :)

dhansel, 2023-09-25:
> `/home/pebe/Arduino/ArduFDD2SIO/ArduinoFDC.cpp:1090:63: error: matching constraint references invalid operand number`

I think this error occurs because after adding "r27" in the inputs list you now have "r27" in both the inputs and clobbers list (the clobbers list informs the compiler which registers are used by your assembly code so the compiler can't count on them being the same after your code finishes. Remove "r27" from the clobbers list and try again.

If you leave out the "27" then the compiler will just choose a register. That's a possibility too but then you'll have to modify the assembly code to use the register that the compiler chose. If you look at the assembly code you can see how I did that with the "bitlen", "numsec" etc. values.

GSoftwareDevelopment, 2023-09-26:
> Remove "r27" from the clobbers list and try again.
```
     : "r"(bitlen), "r"(numsec), "r"(datagaplen), "z"(buffer), "r27"(bytesHi) // inputs (z=r30/r31)
     : "r16", "r17", "r18", "r19", "r20", "r21", "r26"); // clobbers
```
Unfortunately, it gave exactly the same error :/.
```
/home/pebe/Arduino/ArduFDD2SIO/ArduinoFDC.cpp:1090:56: error: matching constraint references invalid operand number
      : "r16", "r17", "r18", "r19", "r20", "r21", "r26"); // clobbers
```

As such, the whole thing compiles Only when there is such a notation:
```
     : "r"(bitlen), "r"(numsec), "r"(datagaplen), "z"(buffer), "r"(bytesHi) // inputs (z=r30/r31)
     : "r16", "r17", "r18", "r19", "r20", "r21", "r26", "r27"); // clobbers
```

> If you leave out the "27" then the compiler will just choose a register.

Ok. I looked at it and I hope I made a good observation :)
The `bitlen` is allocated to the `r` register. In the code, access to its value is through `%0`.
`numsec` similarly, and access is through `%1`.
`datagaplen` = %2
The `buffer` will "sit" in `r30` and `r31` - I don't understand this `z` a bit :) However, `%3` is no longer present, but instead there is `Z+` in the code.

Simple conclusion.
Passing variables through `r` gives access through `%n`, where `n` is the next number (counting from zero) of the parameter, passed in the list:
```
//        %0           %1           %2               ? but r30/r31
    : "r"(bitlen), "r"(numsec), "r"(datagaplen), "z"(buffer)
```
That is, if I add to this list `"r"(bytesHi)`....
```
    : "r"(bitlen), "r"(numsec), "r"(datagaplen), "r"(bytesHi), "z"(buffer)
```
...then the value of the variable, will be available through `%3`.

That is, in the place where the number of bytes per sector is set in registers `r26` and `r27`, I should do so:
```
    ldi r26, 0
    ldi r27, %3
```
Do I understand correctly? :)

---
If the above is true then taking into account the sector of 128 bytes, you could do for example like this:
```
    ldi r26, 0  // when `bytesHi` > 0,
    ldi r27, %3 // sets the sector size for 256 and 512 (or multiples of 256)
    brne beginSec
    ldi r26, 128 // when `bytesHi` = 0
    ldi r27, 0   // assumes a sector size of 128 bytes
beginSec:
    WRTPS
    rjmp dskip
dloop: ...
```

I would appreciate your reference to the above "deduction" :)

dhansel, 2023-09-27:
> Unfortunately, it gave exactly the same error :/.

As I said it's been a while since I worked on this code (or any ATMEL assembly). Not sure what else could be the problem.
You may want to take a look here: https://www.nongnu.org/avr-libc/user-manual/inline_asm.html
That's where I got a lot of info as to how the "asm" statement works and how to pass values.

> Passing variables through r gives access through %n, where n is the next number (counting from zero) of the parameter, passed in the list

That's the general idea. It _should_ work but I can't vouch for it without trying it by myself. One way to check whether the compiler did the right thing is to take a look at the generated assembly code. You can dump the assembly code using this command: `avr-objdump.exe -S ArduinoFDC.ino.elf > ArduinoFDC.s` [where ArduinoFDC.ino.elf is the .elf file produced by the compiler and ArduinoFDC.s will be the resulting assembly file.

The result isn't exactly easy to navigate but if you look closely you can check whether it's using the right registers.

you can also un-comment the "#define DEBUG" statement in ArduinoFDC.cpp to get some debugging info dumped
to the Serial port. It's not a lot but may be helpful. Make sure you have the serial port set to 115200 baud, otherwise
the debug output will slow down the code too much and it won't work anymore.

Let us know if/how this worked out for you!

GSoftwareDevelopment, 2023-09-27:
Ok, dzięki za wsparcie wszelakie - bardzo doceniam przekazane mi informacje.
Jeśli uda mi się uzyskać więcej szczegółów za pośrednictwem `avr-objdump` postaram się z pewnością dojść do jakiegoś konsensusu.

Dzięki bardzo i nie przedłużam "agonii" spowodowanej męczącymi pytaniami i powrotem do przeszłości ;)

Życzę zdrowia.

Thread 11 (2023-09-21):

Problem with changing the floppy disk.

GSoftwareDevelopment, 2023-09-21:
Hello.

By way of introduction - great project. I'm just playing with it and I'm going to use it as an interface for Atari 8-bit :) however...

The problem is that changing the floppy disk is not checked. It appears as follows:
1. I start the project.
2. I insert a floppy disk
3. I do for example `dir` - it shows me that it is empty and the amount of free space
4. I change the floppy disk to another one
5. I do `dir` and again it shows that it is empty and the same amount of free space - it is already suspicious.
6. I do a reset of Arduino
7. The same floppy disk as in point 4
8. I do `dir` and it shows the contents of the floppy disk - some files.

GSoftwareDevelopment, 2023-09-21:
Thank you for your quick reply :) and my apologies, I must not have read.

Myślę, że można zamknąć temat. Pozdrawiam.

GSoftwareDevelopment, 2023-09-21:
Or not. :)

What is the reason for the lack of detection?

dhansel, 2023-09-22:
Laziness :) I was focused on reading/writing the actual data, which is what the ArduinoFDC library is about.
Adding ArduDOS was just an idea to demonstrate what can be done using the library.

Checking whether the disk has changed is not hard. Just connect pin 33 of the floppy cable to an unused
Arduino pin. In the sketch, call `pinMode(pin, INPUT_PULLUP)` to configure the input pin. Then you can
use `if( digitalRead(pin)==LOW ) { /* disk change detected */ }` to detect the change.

Note that the pin will **continue** reading LOW until you clear the "disk change" flag in the drive.
The only way to clear that flag is to move the disk drive head. So you'll have to (attempt to) read some
sector data on a track different from the one that the head is currently on.

GSoftwareDevelopment, 2023-09-22:
heh... I see, I asked because I thought it was something more complicated :)

By the way, thanks for giving the way.

However... pin 33? isn't that GND by any chance? ;)
I noticed, while looking for information about the DSKCHG# signal (i.e. pin 34), that - according to [Wiki](https://en.wikipedia.org/wiki/Floppy_disk_drive_interface) - it's an input pin, which surprises me a bit, that you set `pinMode()` to `INPUT_PULLUP` no but.... there's always a chance that there's an error in the Wiki :)

dhansel, 2023-09-22:
Oops sorry yes I meant pin 34. I fixed it in my original comment so as to not misinform anybody reading this thread. Thanks for the correction!

Closed 2023-09-25.

Thread 12 (2023-09-27):

Very slow xmodem transfer, errors

slayernn021, 2023-09-27:
Hello! Im trying to copy files from old floppys, 3.5 using arduino mega, psu as ps. When i start receiving file via xmodem, it takes ~10min for 1kb and it gives lots of errors. Same with other floppy disks. I try using pullup resistor, and its same. All GND's are correct. What can be problem and where to look? Is there other way to copy files to computer except xmodem? Thanx!!

dhansel, 2023-09-27:
First thing to figure out is whether the problem is with XModem or reading the data itself. What do you get when you execute the "r" command (read whole disk and print pass/fail for each sector). Do you get lots of read errors? If so, try using an empty disk, format it and then try the "r" command. If that works then the other disk is likely to old/degraded to read using ArduinoFDC. If it still doesn't work then maybe the disk drive you are using has problems.

If the "r" command works without issues then the problem is likely your serial connection between the Arduino and the PC. What terminal program do you use for the transfer? I've had good luck with TeraTerm.

Note that ArduinoFDC is not meant to archive old disks. It's purpose was to use an Arduino UNO to write and read data on floppy disks. ArduinoFDC _can_ be used for archiving if your disks and drive are in good condition. But it is not very good at error correction (because of the limited resources like speed/memory of the Arduino UNO). If you really want to archive disks I recommend using Greaseweazle/FluxEngine which read low-level data from a floppy and then use the power of a PC to interpret the data and correct possible errors.

thstrauss, 2023-10-02:
I had an issue with XModem transfer in my attempt do write a program which saves the content of an whole disk. Is solved it with using the implementation that is part of arduinoFDC on the PC. TeraTerm  also works perfect for me.

Closed 2023-10-03.

Thread 13 (2023-11-08):

Problem when compile the code

thiago1255, 2023-11-08:
When i try compile the code i get this:
```
Arduino: 1.8.19 (Linux), Board: "Arduino Mega or Mega 2560, ATmega2560 (Mega 2560)"

arduino-builder -dump-prefs -logger=machine -hardware /usr/share/arduino/hardware -hardware /home/internet/.arduino15/packages -tools /usr/share/arduino/hardware/tools/avr -tools /home/internet/.arduino15/packages -libraries /home/internet/Arduino/libraries -fqbn=arduino:avr:mega:cpu=atmega2560 -ide-version=10819 -build-path /tmp/arduino_build_548072 -warnings=none -build-cache /tmp/arduino_cache_167950 -prefs=build.warn_data_percentage=75 -prefs=runtime.tools.avr-gcc.path=/home/internet/.arduino15/packages/arduino/tools/avr-gcc/7.3.0-atmel3.6.1-arduino7 -prefs=runtime.tools.avr-gcc-7.3.0-atmel3.6.1-arduino7.path=/home/internet/.arduino15/packages/arduino/tools/avr-gcc/7.3.0-atmel3.6.1-arduino7 -prefs=runtime.tools.arduinoOTA.path=/home/internet/.arduino15/packages/arduino/tools/arduinoOTA/1.3.0 -prefs=runtime.tools.arduinoOTA-1.3.0.path=/home/internet/.arduino15/packages/arduino/tools/arduinoOTA/1.3.0 -prefs=runtime.tools.avrdude.path=/home/internet/.arduino15/packages/arduino/tools/avrdude/6.3.0-arduino17 -prefs=runtime.tools.avrdude-6.3.0-arduino17.path=/home/internet/.arduino15/packages/arduino/tools/avrdude/6.3.0-arduino17 -verbose /home/internet/Documentos/ArduinoFDC/ArduinoFDC.ino
arduino-builder -compile -logger=machine -hardware /usr/share/arduino/hardware -hardware /home/internet/.arduino15/packages -tools /usr/share/arduino/hardware/tools/avr -tools /home/internet/.arduino15/packages -libraries /home/internet/Arduino/libraries -fqbn=arduino:avr:mega:cpu=atmega2560 -ide-version=10819 -build-path /tmp/arduino_build_548072 -warnings=none -build-cache /tmp/arduino_cache_167950 -prefs=build.warn_data_percentage=75 -prefs=runtime.tools.avr-gcc.path=/home/internet/.arduino15/packages/arduino/tools/avr-gcc/7.3.0-atmel3.6.1-arduino7 -prefs=runtime.tools.avr-gcc-7.3.0-atmel3.6.1-arduino7.path=/home/internet/.arduino15/packages/arduino/tools/avr-gcc/7.3.0-atmel3.6.1-arduino7 -prefs=runtime.tools.arduinoOTA.path=/home/internet/.arduino15/packages/arduino/tools/arduinoOTA/1.3.0 -prefs=runtime.tools.arduinoOTA-1.3.0.path=/home/internet/.arduino15/packages/arduino/tools/arduinoOTA/1.3.0 -prefs=runtime.tools.avrdude.path=/home/internet/.arduino15/packages/arduino/tools/avrdude/6.3.0-arduino17 -prefs=runtime.tools.avrdude-6.3.0-arduino17.path=/home/internet/.arduino15/packages/arduino/tools/avrdude/6.3.0-arduino17 -verbose /home/internet/Documentos/ArduinoFDC/ArduinoFDC.ino
Using board 'mega' from platform in folder: /home/internet/.arduino15/packages/arduino/hardware/avr/1.8.6
Using core 'arduino' from platform in folder: /home/internet/.arduino15/packages/arduino/hardware/avr/1.8.6
Warning: platform.txt from core 'Arduino AVR Boards' contains deprecated compiler.path={runtime.tools.avr-gcc.path}/bin/, automatically converted to compiler.path=/usr/bin/. Consider upgrading this core.
Detecting libraries used...
"/usr/bin/avr-g++" -c -g -Os -w -std=gnu++11 -fpermissive -fno-exceptions -ffunction-sections -fdata-sections -fno-threadsafe-statics -Wno-error=narrowing  -flto -w -x c++ -E -CC -mmcu=atmega2560 -DF_CPU=16000000L -DARDUINO=10819 -DARDUINO_AVR_MEGA2560 -DARDUINO_ARCH_AVR   "-I/home/internet/.arduino15/packages/arduino/hardware/avr/1.8.6/cores/arduino" "-I/home/internet/.arduino15/packages/arduino/hardware/avr/1.8.6/variants/mega" "/tmp/arduino_build_548072/sketch/ArduinoFDC.ino.cpp" -o "/dev/null"
"/usr/bin/avr-g++" -c -g -Os -w -std=gnu++11 -fpermissive -fno-exceptions -ffunction-sections -fdata-sections -fno-threadsafe-statics -Wno-error=narrowing  -flto -w -x c++ -E -CC -mmcu=atmega2560 -DF_CPU=16000000L -DARDUINO=10819 -DARDUINO_AVR_MEGA2560 -DARDUINO_ARCH_AVR   "-I/home/internet/.arduino15/packages/arduino/hardware/avr/1.8.6/cores/arduino" "-I/home/internet/.arduino15/packages/arduino/hardware/avr/1.8.6/variants/mega" "/tmp/arduino_build_548072/sketch/ArduinoFDC.cpp" -o "/dev/null"
"/usr/bin/avr-g++" -c -g -Os -w -std=gnu++11 -fpermissive -fno-exceptions -ffunction-sections -fdata-sections -fno-threadsafe-statics -Wno-error=narrowing  -flto -w -x c++ -E -CC -mmcu=atmega2560 -DF_CPU=16000000L -DARDUINO=10819 -DARDUINO_AVR_MEGA2560 -DARDUINO_ARCH_AVR   "-I/home/internet/.arduino15/packages/arduino/hardware/avr/1.8.6/cores/arduino" "-I/home/internet/.arduino15/packages/arduino/hardware/avr/1.8.6/variants/mega" "/tmp/arduino_build_548072/sketch/XModem.cpp" -o "/dev/null"
"/usr/bin/avr-g++" -c -g -Os -w -std=gnu++11 -fpermissive -fno-exceptions -ffunction-sections -fdata-sections -fno-threadsafe-statics -Wno-error=narrowing  -flto -w -x c++ -E -CC -mmcu=atmega2560 -DF_CPU=16000000L -DARDUINO=10819 -DARDUINO_AVR_MEGA2560 -DARDUINO_ARCH_AVR   "-I/home/internet/.arduino15/packages/arduino/hardware/avr/1.8.6/cores/arduino" "-I/home/internet/.arduino15/packages/arduino/hardware/avr/1.8.6/variants/mega" "/tmp/arduino_build_548072/sketch/diskio.cpp" -o "/dev/null"
"/usr/bin/avr-g++" -c -g -Os -w -std=gnu++11 -fpermissive -fno-exceptions -ffunction-sections -fdata-sections -fno-threadsafe-statics -Wno-error=narrowing  -flto -w -x c++ -E -CC -mmcu=atmega2560 -DF_CPU=16000000L -DARDUINO=10819 -DARDUINO_AVR_MEGA2560 -DARDUINO_ARCH_AVR   "-I/home/internet/.arduino15/packages/arduino/hardware/avr/1.8.6/cores/arduino" "-I/home/internet/.arduino15/packages/arduino/hardware/avr/1.8.6/variants/mega" "/tmp/arduino_build_548072/sketch/ff.c" -o "/dev/null"
Generating function prototypes...
"/usr/bin/avr-g++" -c -g -Os -w -std=gnu++11 -fpermissive -fno-exceptions -ffunction-sections -fdata-sections -fno-threadsafe-statics -Wno-error=narrowing  -flto -w -x c++ -E -CC -mmcu=atmega2560 -DF_CPU=16000000L -DARDUINO=10819 -DARDUINO_AVR_MEGA2560 -DARDUINO_ARCH_AVR   "-I/home/internet/.arduino15/packages/arduino/hardware/avr/1.8.6/cores/arduino" "-I/home/internet/.arduino15/packages/arduino/hardware/avr/1.8.6/variants/mega" "/tmp/arduino_build_548072/sketch/ArduinoFDC.ino.cpp" -o "/tmp/arduino_build_548072/preproc/ctags_target_for_gcc_minus_e.cpp"
"/usr/bin/arduino-ctags" -u --language-force=c++ -f - --c++-kinds=svpf --fields=KSTtzns --line-directives "/tmp/arduino_build_548072/preproc/ctags_target_for_gcc_minus_e.cpp"
Compiling sketch...
"/usr/bin/avr-gcc" -c -g -Os -w -std=gnu11 -ffunction-sections -fdata-sections -MMD -flto -fno-fat-lto-objects -mmcu=atmega2560 -DF_CPU=16000000L -DARDUINO=10819 -DARDUINO_AVR_MEGA2560 -DARDUINO_ARCH_AVR   "-I/home/internet/.arduino15/packages/arduino/hardware/avr/1.8.6/cores/arduino" "-I/home/internet/.arduino15/packages/arduino/hardware/avr/1.8.6/variants/mega" "/tmp/arduino_build_548072/sketch/ff.c" -o "/tmp/arduino_build_548072/sketch/ff.c.o"
"/usr/bin/avr-g++" -c -g -Os -w -std=gnu++11 -fpermissive -fno-exceptions -ffunction-sections -fdata-sections -fno-threadsafe-statics -Wno-error=narrowing -MMD -flto -mmcu=atmega2560 -DF_CPU=16000000L -DARDUINO=10819 -DARDUINO_AVR_MEGA2560 -DARDUINO_ARCH_AVR   "-I/home/internet/.arduino15/packages/arduino/hardware/avr/1.8.6/cores/arduino" "-I/home/internet/.arduino15/packages/arduino/hardware/avr/1.8.6/variants/mega" "/tmp/arduino_build_548072/sketch/ArduinoFDC.cpp" -o "/tmp/arduino_build_548072/sketch/ArduinoFDC.cpp.o"
"/usr/bin/avr-g++" -c -g -Os -w -std=gnu++11 -fpermissive -fno-exceptions -ffunction-sections -fdata-sections -fno-threadsafe-statics -Wno-error=narrowing -MMD -flto -mmcu=atmega2560 -DF_CPU=16000000L -DARDUINO=10819 -DARDUINO_AVR_MEGA2560 -DARDUINO_ARCH_AVR   "-I/home/internet/.arduino15/packages/arduino/hardware/avr/1.8.6/cores/arduino" "-I/home/internet/.arduino15/packages/arduino/hardware/avr/1.8.6/variants/mega" "/tmp/arduino_build_548072/sketch/ArduinoFDC.ino.cpp" -o "/tmp/arduino_build_548072/sketch/ArduinoFDC.ino.cpp.o"
"/usr/bin/avr-g++" -c -g -Os -w -std=gnu++11 -fpermissive -fno-exceptions -ffunction-sections -fdata-sections -fno-threadsafe-statics -Wno-error=narrowing -MMD -flto -mmcu=atmega2560 -DF_CPU=16000000L -DARDUINO=10819 -DARDUINO_AVR_MEGA2560 -DARDUINO_ARCH_AVR   "-I/home/internet/.arduino15/packages/arduino/hardware/avr/1.8.6/cores/arduino" "-I/home/internet/.arduino15/packages/arduino/hardware/avr/1.8.6/variants/mega" "/tmp/arduino_build_548072/sketch/XModem.cpp" -o "/tmp/arduino_build_548072/sketch/XModem.cpp.o"
"/usr/bin/avr-g++" -c -g -Os -w -std=gnu++11 -fpermissive -fno-exceptions -ffunction-sections -fdata-sections -fno-threadsafe-statics -Wno-error=narrowing -MMD -flto -mmcu=atmega2560 -DF_CPU=16000000L -DARDUINO=10819 -DARDUINO_AVR_MEGA2560 -DARDUINO_ARCH_AVR   "-I/home/internet/.arduino15/packages/arduino/hardware/avr/1.8.6/cores/arduino" "-I/home/internet/.arduino15/packages/arduino/hardware/avr/1.8.6/variants/mega" "/tmp/arduino_build_548072/sketch/diskio.cpp" -o "/tmp/arduino_build_548072/sketch/diskio.cpp.o"
Compiling libraries...
Compiling core...
"/usr/bin/avr-gcc" -c -g -x assembler-with-cpp -flto -MMD -mmcu=atmega2560 -DF_CPU=16000000L -DARDUINO=10819 -DARDUINO_AVR_MEGA2560 -DARDUINO_ARCH_AVR   "-I/home/internet/.arduino15/packages/arduino/hardware/avr/1.8.6/cores/arduino" "-I/home/internet/.arduino15/packages/arduino/hardware/avr/1.8.6/variants/mega" "/home/internet/.arduino15/packages/arduino/hardware/avr/1.8.6/cores/arduino/wiring_pulse.S" -o "/tmp/arduino_build_548072/core/wiring_pulse.S.o"
"/usr/bin/avr-gcc" -c -g -Os -w -std=gnu11 -ffunction-sections -fdata-sections -MMD -flto -fno-fat-lto-objects -mmcu=atmega2560 -DF_CPU=16000000L -DARDUINO=10819 -DARDUINO_AVR_MEGA2560 -DARDUINO_ARCH_AVR   "-I/home/internet/.arduino15/packages/arduino/hardware/avr/1.8.6/cores/arduino" "-I/home/internet/.arduino15/packages/arduino/hardware/avr/1.8.6/variants/mega" "/home/internet/.arduino15/packages/arduino/hardware/avr/1.8.6/cores/arduino/WInterrupts.c" -o "/tmp/arduino_build_548072/core/WInterrupts.c.o"
"/usr/bin/avr-gcc" -c -g -Os -w -std=gnu11 -ffunction-sections -fdata-sections -MMD -flto -fno-fat-lto-objects -mmcu=atmega2560 -DF_CPU=16000000L -DARDUINO=10819 -DARDUINO_AVR_MEGA2560 -DARDUINO_ARCH_AVR   "-I/home/internet/.arduino15/packages/arduino/hardware/avr/1.8.6/cores/arduino" "-I/home/internet/.arduino15/packages/arduino/hardware/avr/1.8.6/variants/mega" "/home/internet/.arduino15/packages/arduino/hardware/avr/1.8.6/cores/arduino/hooks.c" -o "/tmp/arduino_build_548072/core/hooks.c.o"
"/usr/bin/avr-gcc" -c -g -Os -w -std=gnu11 -ffunction-sections -fdata-sections -MMD -flto -fno-fat-lto-objects -mmcu=atmega2560 -DF_CPU=16000000L -DARDUINO=10819 -DARDUINO_AVR_MEGA2560 -DARDUINO_ARCH_AVR   "-I/home/internet/.arduino15/packages/arduino/hardware/avr/1.8.6/cores/arduino" "-I/home/internet/.arduino15/packages/arduino/hardware/avr/1.8.6/variants/mega" "/home/internet/.arduino15/packages/arduino/hardware/avr/1.8.6/cores/arduino/wiring.c" -o "/tmp/arduino_build_548072/core/wiring.c.o"
"/usr/bin/avr-gcc" -c -g -Os -w -std=gnu11 -ffunction-sections -fdata-sections -MMD -flto -fno-fat-lto-objects -mmcu=atmega2560 -DF_CPU=16000000L -DARDUINO=10819 -DARDUINO_AVR_MEGA2560 -DARDUINO_ARCH_AVR   "-I/home/internet/.arduino15/packages/arduino/hardware/avr/1.8.6/cores/arduino" "-I/home/internet/.arduino15/packages/arduino/hardware/avr/1.8.6/variants/mega" "/home/internet/.arduino15/packages/arduino/hardware/avr/1.8.6/cores/arduino/wiring_analog.c" -o "/tmp/arduino_build_548072/core/wiring_analog.c.o"
"/usr/bin/avr-gcc" -c -g -Os -w -std=gnu11 -ffunction-sections -fdata-sections -MMD -flto -fno-fat-lto-objects -mmcu=atmega2560 -DF_CPU=16000000L -DARDUINO=10819 -DARDUINO_AVR_MEGA2560 -DARDUINO_ARCH_AVR   "-I/home/internet/.arduino15/packages/arduino/hardware/avr/1.8.6/cores/arduino" "-I/home/internet/.arduino15/packages/arduino/hardware/avr/1.8.6/variants/mega" "/home/internet/.arduino15/packages/arduino/hardware/avr/1.8.6/cores/arduino/wiring_digital.c" -o "/tmp/arduino_build_548072/core/wiring_digital.c.o"
"/usr/bin/avr-gcc" -c -g -Os -w -std=gnu11 -ffunction-sections -fdata-sections -MMD -flto -fno-fat-lto-objects -mmcu=atmega2560 -DF_CPU=16000000L -DARDUINO=10819 -DARDUINO_AVR_MEGA2560 -DARDUINO_ARCH_AVR   "-I/home/internet/.arduino15/packages/arduino/hardware/avr/1.8.6/cores/arduino" "-I/home/internet/.arduino15/packages/arduino/hardware/avr/1.8.6/variants/mega" "/home/internet/.arduino15/packages/arduino/hardware/avr/1.8.6/cores/arduino/wiring_pulse.c" -o "/tmp/arduino_build_548072/core/wiring_pulse.c.o"
"/usr/bin/avr-gcc" -c -g -Os -w -std=gnu11 -ffunction-sections -fdata-sections -MMD -flto -fno-fat-lto-objects -mmcu=atmega2560 -DF_CPU=16000000L -DARDUINO=10819 -DARDUINO_AVR_MEGA2560 -DARDUINO_ARCH_AVR   "-I/home/internet/.arduino15/packages/arduino/hardware/avr/1.8.6/cores/arduino" "-I/home/internet/.arduino15/packages/arduino/hardware/avr/1.8.6/variants/mega" "/home/internet/.arduino15/packages/arduino/hardware/avr/1.8.6/cores/arduino/wiring_shift.c" -o "/tmp/arduino_build_548072/core/wiring_shift.c.o"
"/usr/bin/avr-g++" -c -g -Os -w -std=gnu++11 -fpermissive -fno-exceptions -ffunction-sections -fdata-sections -fno-threadsafe-statics -Wno-error=narrowing -MMD -flto -mmcu=atmega2560 -DF_CPU=16000000L -DARDUINO=10819 -DARDUINO_AVR_MEGA2560 -DARDUINO_ARCH_AVR   "-I/home/internet/.arduino15/packages/arduino/hardware/avr/1.8.6/cores/arduino" "-I/home/internet/.arduino15/packages/arduino/hardware/avr/1.8.6/variants/mega" "/home/internet/.arduino15/packages/arduino/hardware/avr/1.8.6/cores/arduino/CDC.cpp" -o "/tmp/arduino_build_548072/core/CDC.cpp.o"
"/usr/bin/avr-g++" -c -g -Os -w -std=gnu++11 -fpermissive -fno-exceptions -ffunction-sections -fdata-sections -fno-threadsafe-statics -Wno-error=narrowing -MMD -flto -mmcu=atmega2560 -DF_CPU=16000000L -DARDUINO=10819 -DARDUINO_AVR_MEGA2560 -DARDUINO_ARCH_AVR   "-I/home/internet/.arduino15/packages/arduino/hardware/avr/1.8.6/cores/arduino" "-I/home/internet/.arduino15/packages/arduino/hardware/avr/1.8.6/variants/mega" "/home/internet/.arduino15/packages/arduino/hardware/avr/1.8.6/cores/arduino/HardwareSerial.cpp" -o "/tmp/arduino_build_548072/core/HardwareSerial.cpp.o"
"/usr/bin/avr-g++" -c -g -Os -w -std=gnu++11 -fpermissive -fno-exceptions -ffunction-sections -fdata-sections -fno-threadsafe-statics -Wno-error=narrowing -MMD -flto -mmcu=atmega2560 -DF_CPU=16000000L -DARDUINO=10819 -DARDUINO_AVR_MEGA2560 -DARDUINO_ARCH_AVR   "-I/home/internet/.arduino15/packages/arduino/hardware/avr/1.8.6/cores/arduino" "-I/home/internet/.arduino15/packages/arduino/hardware/avr/1.8.6/variants/mega" "/home/internet/.arduino15/packages/arduino/hardware/avr/1.8.6/cores/arduino/HardwareSerial0.cpp" -o "/tmp/arduino_build_548072/core/HardwareSerial0.cpp.o"
"/usr/bin/avr-g++" -c -g -Os -w -std=gnu++11 -fpermissive -fno-exceptions -ffunction-sections -fdata-sections -fno-threadsafe-statics -Wno-error=narrowing -MMD -flto -mmcu=atmega2560 -DF_CPU=16000000L -DARDUINO=10819 -DARDUINO_AVR_MEGA2560 -DARDUINO_ARCH_AVR   "-I/home/internet/.arduino15/packages/arduino/hardware/avr/1.8.6/cores/arduino" "-I/home/internet/.arduino15/packages/arduino/hardware/avr/1.8.6/variants/mega" "/home/internet/.arduino15/packages/arduino/hardware/avr/1.8.6/cores/arduino/HardwareSerial1.cpp" -o "/tmp/arduino_build_548072/core/HardwareSerial1.cpp.o"
"/usr/bin/avr-g++" -c -g -Os -w -std=gnu++11 -fpermissive -fno-exceptions -ffunction-sections -fdata-sections -fno-threadsafe-statics -Wno-error=narrowing -MMD -flto -mmcu=atmega2560 -DF_CPU=16000000L -DARDUINO=10819 -DARDUINO_AVR_MEGA2560 -DARDUINO_ARCH_AVR   "-I/home/internet/.arduino15/packages/arduino/hardware/avr/1.8.6/cores/arduino" "-I/home/internet/.arduino15/packages/arduino/hardware/avr/1.8.6/variants/mega" "/home/internet/.arduino15/packages/arduino/hardware/avr/1.8.6/cores/arduino/HardwareSerial2.cpp" -o "/tmp/arduino_build_548072/core/HardwareSerial2.cpp.o"
"/usr/bin/avr-g++" -c -g -Os -w -std=gnu++11 -fpermissive -fno-exceptions -ffunction-sections -fdata-sections -fno-threadsafe-statics -Wno-error=narrowing -MMD -flto -mmcu=atmega2560 -DF_CPU=16000000L -DARDUINO=10819 -DARDUINO_AVR_MEGA2560 -DARDUINO_ARCH_AVR   "-I/home/internet/.arduino15/packages/arduino/hardware/avr/1.8.6/cores/arduino" "-I/home/internet/.arduino15/packages/arduino/hardware/avr/1.8.6/variants/mega" "/home/internet/.arduino15/packages/arduino/hardware/avr/1.8.6/cores/arduino/HardwareSerial3.cpp" -o "/tmp/arduino_build_548072/core/HardwareSerial3.cpp.o"
"/usr/bin/avr-g++" -c -g -Os -w -std=gnu++11 -fpermissive -fno-exceptions -ffunction-sections -fdata-sections -fno-threadsafe-statics -Wno-error=narrowing -MMD -flto -mmcu=atmega2560 -DF_CPU=16000000L -DARDUINO=10819 -DARDUINO_AVR_MEGA2560 -DARDUINO_ARCH_AVR   "-I/home/internet/.arduino15/packages/arduino/hardware/avr/1.8.6/cores/arduino" "-I/home/internet/.arduino15/packages/arduino/hardware/avr/1.8.6/variants/mega" "/home/internet/.arduino15/packages/arduino/hardware/avr/1.8.6/cores/arduino/IPAddress.cpp" -o "/tmp/arduino_build_548072/core/IPAddress.cpp.o"
"/usr/bin/avr-g++" -c -g -Os -w -std=gnu++11 -fpermissive -fno-exceptions -ffunction-sections -fdata-sections -fno-threadsafe-statics -Wno-error=narrowing -MMD -flto -mmcu=atmega2560 -DF_CPU=16000000L -DARDUINO=10819 -DARDUINO_AVR_MEGA2560 -DARDUINO_ARCH_AVR   "-I/home/internet/.arduino15/packages/arduino/hardware/avr/1.8.6/cores/arduino" "-I/home/internet/.arduino15/packages/arduino/hardware/avr/1.8.6/variants/mega" "/home/internet/.arduino15/packages/arduino/hardware/avr/1.8.6/cores/arduino/PluggableUSB.cpp" -o "/tmp/arduino_build_548072/core/PluggableUSB.cpp.o"
"/usr/bin/avr-g++" -c -g -Os -w -std=gnu++11 -fpermissive -fno-exceptions -ffunction-sections -fdata-sections -fno-threadsafe-statics -Wno-error=narrowing -MMD -flto -mmcu=atmega2560 -DF_CPU=16000000L -DARDUINO=10819 -DARDUINO_AVR_MEGA2560 -DARDUINO_ARCH_AVR   "-I/home/internet/.arduino15/packages/arduino/hardware/avr/1.8.6/cores/arduino" "-I/home/internet/.arduino15/packages/arduino/hardware/avr/1.8.6/variants/mega" "/home/internet/.arduino15/packages/arduino/hardware/avr/1.8.6/cores/arduino/Print.cpp" -o "/tmp/arduino_build_548072/core/Print.cpp.o"
"/usr/bin/avr-g++" -c -g -Os -w -std=gnu++11 -fpermissive -fno-exceptions -ffunction-sections -fdata-sections -fno-threadsafe-statics -Wno-error=narrowing -MMD -flto -mmcu=atmega2560 -DF_CPU=16000000L -DARDUINO=10819 -DARDUINO_AVR_MEGA2560 -DARDUINO_ARCH_AVR   "-I/home/internet/.arduino15/packages/arduino/hardware/avr/1.8.6/cores/arduino" "-I/home/internet/.arduino15/packages/arduino/hardware/avr/1.8.6/variants/mega" "/home/internet/.arduino15/packages/arduino/hardware/avr/1.8.6/cores/arduino/Stream.cpp" -o "/tmp/arduino_build_548072/core/Stream.cpp.o"
"/usr/bin/avr-g++" -c -g -Os -w -std=gnu++11 -fpermissive -fno-exceptions -ffunction-sections -fdata-sections -fno-threadsafe-statics -Wno-error=narrowing -MMD -flto -mmcu=atmega2560 -DF_CPU=16000000L -DARDUINO=10819 -DARDUINO_AVR_MEGA2560 -DARDUINO_ARCH_AVR   "-I/home/internet/.arduino15/packages/arduino/hardware/avr/1.8.6/cores/arduino" "-I/home/internet/.arduino15/packages/arduino/hardware/avr/1.8.6/variants/mega" "/home/internet/.arduino15/packages/arduino/hardware/avr/1.8.6/cores/arduino/Tone.cpp" -o "/tmp/arduino_build_548072/core/Tone.cpp.o"
"/usr/bin/avr-g++" -c -g -Os -w -std=gnu++11 -fpermissive -fno-exceptions -ffunction-sections -fdata-sections -fno-threadsafe-statics -Wno-error=narrowing -MMD -flto -mmcu=atmega2560 -DF_CPU=16000000L -DARDUINO=10819 -DARDUINO_AVR_MEGA2560 -DARDUINO_ARCH_AVR   "-I/home/internet/.arduino15/packages/arduino/hardware/avr/1.8.6/cores/arduino" "-I/home/internet/.arduino15/packages/arduino/hardware/avr/1.8.6/variants/mega" "/home/internet/.arduino15/packages/arduino/hardware/avr/1.8.6/cores/arduino/USBCore.cpp" -o "/tmp/arduino_build_548072/core/USBCore.cpp.o"
"/usr/bin/avr-g++" -c -g -Os -w -std=gnu++11 -fpermissive -fno-exceptions -ffunction-sections -fdata-sections -fno-threadsafe-statics -Wno-error=narrowing -MMD -flto -mmcu=atmega2560 -DF_CPU=16000000L -DARDUINO=10819 -DARDUINO_AVR_MEGA2560 -DARDUINO_ARCH_AVR   "-I/home/internet/.arduino15/packages/arduino/hardware/avr/1.8.6/cores/arduino" "-I/home/internet/.arduino15/packages/arduino/hardware/avr/1.8.6/variants/mega" "/home/internet/.arduino15/packages/arduino/hardware/avr/1.8.6/cores/arduino/WMath.cpp" -o "/tmp/arduino_build_548072/core/WMath.cpp.o"
"/usr/bin/avr-g++" -c -g -Os -w -std=gnu++11 -fpermissive -fno-exceptions -ffunction-sections -fdata-sections -fno-threadsafe-statics -Wno-error=narrowing -MMD -flto -mmcu=atmega2560 -DF_CPU=16000000L -DARDUINO=10819 -DARDUINO_AVR_MEGA2560 -DARDUINO_ARCH_AVR   "-I/home/internet/.arduino15/packages/arduino/hardware/avr/1.8.6/cores/arduino" "-I/home/internet/.arduino15/packages/arduino/hardware/avr/1.8.6/variants/mega" "/home/internet/.arduino15/packages/arduino/hardware/avr/1.8.6/cores/arduino/WString.cpp" -o "/tmp/arduino_build_548072/core/WString.cpp.o"
"/usr/bin/avr-g++" -c -g -Os -w -std=gnu++11 -fpermissive -fno-exceptions -ffunction-sections -fdata-sections -fno-threadsafe-statics -Wno-error=narrowing -MMD -flto -mmcu=atmega2560 -DF_CPU=16000000L -DARDUINO=10819 -DARDUINO_AVR_MEGA2560 -DARDUINO_ARCH_AVR   "-I/home/internet/.arduino15/packages/arduino/hardware/avr/1.8.6/cores/arduino" "-I/home/internet/.arduino15/packages/arduino/hardware/avr/1.8.6/variants/mega" "/home/internet/.arduino15/packages/arduino/hardware/avr/1.8.6/cores/arduino/abi.cpp" -o "/tmp/arduino_build_548072/core/abi.cpp.o"
"/usr/bin/avr-g++" -c -g -Os -w -std=gnu++11 -fpermissive -fno-exceptions -ffunction-sections -fdata-sections -fno-threadsafe-statics -Wno-error=narrowing -MMD -flto -mmcu=atmega2560 -DF_CPU=16000000L -DARDUINO=10819 -DARDUINO_AVR_MEGA2560 -DARDUINO_ARCH_AVR   "-I/home/internet/.arduino15/packages/arduino/hardware/avr/1.8.6/cores/arduino" "-I/home/internet/.arduino15/packages/arduino/hardware/avr/1.8.6/variants/mega" "/home/internet/.arduino15/packages/arduino/hardware/avr/1.8.6/cores/arduino/main.cpp" -o "/tmp/arduino_build_548072/core/main.cpp.o"
"/usr/bin/avr-g++" -c -g -Os -w -std=gnu++11 -fpermissive -fno-exceptions -ffunction-sections -fdata-sections -fno-threadsafe-statics -Wno-error=narrowing -MMD -flto -mmcu=atmega2560 -DF_CPU=16000000L -DARDUINO=10819 -DARDUINO_AVR_MEGA2560 -DARDUINO_ARCH_AVR   "-I/home/internet/.arduino15/packages/arduino/hardware/avr/1.8.6/cores/arduino" "-I/home/internet/.arduino15/packages/arduino/hardware/avr/1.8.6/variants/mega" "/home/internet/.arduino15/packages/arduino/hardware/avr/1.8.6/cores/arduino/new.cpp" -o "/tmp/arduino_build_548072/core/new.cpp.o"
"/usr/bin/avr-gcc-ar" rcs  "/tmp/arduino_build_548072/core/core.a" "/tmp/arduino_build_548072/core/wiring_pulse.S.o"
"/usr/bin/avr-gcc-ar" rcs  "/tmp/arduino_build_548072/core/core.a" "/tmp/arduino_build_548072/core/WInterrupts.c.o"
"/usr/bin/avr-gcc-ar" rcs  "/tmp/arduino_build_548072/core/core.a" "/tmp/arduino_build_548072/core/hooks.c.o"
"/usr/bin/avr-gcc-ar" rcs  "/tmp/arduino_build_548072/core/core.a" "/tmp/arduino_build_548072/core/wiring.c.o"
"/usr/bin/avr-gcc-ar" rcs  "/tmp/arduino_build_548072/core/core.a" "/tmp/arduino_build_548072/core/wiring_analog.c.o"
"/usr/bin/avr-gcc-ar" rcs  "/tmp/arduino_build_548072/core/core.a" "/tmp/arduino_build_548072/core/wiring_digital.c.o"
"/usr/bin/avr-gcc-ar" rcs  "/tmp/arduino_build_548072/core/core.a" "/tmp/arduino_build_548072/core/wiring_pulse.c.o"
"/usr/bin/avr-gcc-ar" rcs  "/tmp/arduino_build_548072/core/core.a" "/tmp/arduino_build_548072/core/wiring_shift.c.o"
"/usr/bin/avr-gcc-ar" rcs  "/tmp/arduino_build_548072/core/core.a" "/tmp/arduino_build_548072/core/CDC.cpp.o"
"/usr/bin/avr-gcc-ar" rcs  "/tmp/arduino_build_548072/core/core.a" "/tmp/arduino_build_548072/core/HardwareSerial.cpp.o"
"/usr/bin/avr-gcc-ar" rcs  "/tmp/arduino_build_548072/core/core.a" "/tmp/arduino_build_548072/core/HardwareSerial0.cpp.o"
"/usr/bin/avr-gcc-ar" rcs  "/tmp/arduino_build_548072/core/core.a" "/tmp/arduino_build_548072/core/HardwareSerial1.cpp.o"
"/usr/bin/avr-gcc-ar" rcs  "/tmp/arduino_build_548072/core/core.a" "/tmp/arduino_build_548072/core/HardwareSerial2.cpp.o"
"/usr/bin/avr-gcc-ar" rcs  "/tmp/arduino_build_548072/core/core.a" "/tmp/arduino_build_548072/core/HardwareSerial3.cpp.o"
"/usr/bin/avr-gcc-ar" rcs  "/tmp/arduino_build_548072/core/core.a" "/tmp/arduino_build_548072/core/IPAddress.cpp.o"
"/usr/bin/avr-gcc-ar" rcs  "/tmp/arduino_build_548072/core/core.a" "/tmp/arduino_build_548072/core/PluggableUSB.cpp.o"
"/usr/bin/avr-gcc-ar" rcs  "/tmp/arduino_build_548072/core/core.a" "/tmp/arduino_build_548072/core/Print.cpp.o"
"/usr/bin/avr-gcc-ar" rcs  "/tmp/arduino_build_548072/core/core.a" "/tmp/arduino_build_548072/core/Stream.cpp.o"
"/usr/bin/avr-gcc-ar" rcs  "/tmp/arduino_build_548072/core/core.a" "/tmp/arduino_build_548072/core/Tone.cpp.o"
"/usr/bin/avr-gcc-ar" rcs  "/tmp/arduino_build_548072/core/core.a" "/tmp/arduino_build_548072/core/USBCore.cpp.o"
"/usr/bin/avr-gcc-ar" rcs  "/tmp/arduino_build_548072/core/core.a" "/tmp/arduino_build_548072/core/WMath.cpp.o"
"/usr/bin/avr-gcc-ar" rcs  "/tmp/arduino_build_548072/core/core.a" "/tmp/arduino_build_548072/core/WString.cpp.o"
"/usr/bin/avr-gcc-ar" rcs  "/tmp/arduino_build_548072/core/core.a" "/tmp/arduino_build_548072/core/abi.cpp.o"
"/usr/bin/avr-gcc-ar" rcs  "/tmp/arduino_build_548072/core/core.a" "/tmp/arduino_build_548072/core/main.cpp.o"
"/usr/bin/avr-gcc-ar" rcs  "/tmp/arduino_build_548072/core/core.a" "/tmp/arduino_build_548072/core/new.cpp.o"
Archiving built core (caching) in: /tmp/arduino_cache_167950/core/core_arduino_avr_mega_cpu_atmega2560_c9058920e18cab3f4bf22bce6c73ea65.a
Linking everything together...
"/usr/bin/avr-gcc" -w -Os -g -flto -fuse-linker-plugin -Wl,--gc-sections,--relax -mmcu=atmega2560   -o "/tmp/arduino_build_548072/ArduinoFDC.ino.elf" "/tmp/arduino_build_548072/sketch/ff.c.o" "/tmp/arduino_build_548072/sketch/ArduinoFDC.cpp.o" "/tmp/arduino_build_548072/sketch/ArduinoFDC.ino.cpp.o" "/tmp/arduino_build_548072/sketch/XModem.cpp.o" "/tmp/arduino_build_548072/sketch/diskio.cpp.o"  "/tmp/arduino_build_548072/core/core.a" "-L/tmp/arduino_build_548072" -lm
/tmp/ccZHqZaS.s: Assembler messages:
/tmp/ccZHqZaS.s:440: Error: constant value required
/tmp/ccZHqZaS.s:442: Error: constant value required
/tmp/ccZHqZaS.s:444: Error: constant value required
/tmp/ccZHqZaS.s:450: Error: constant value required
/tmp/ccZHqZaS.s:450: Error: constant value required
/tmp/ccZHqZaS.s:457: Error: constant value required
/tmp/ccZHqZaS.s:457: Error: constant value required
/tmp/ccZHqZaS.s:458: Error: constant value required
/tmp/ccZHqZaS.s:458: Error: constant value required
/tmp/ccZHqZaS.s:459: Error: constant value required
/tmp/ccZHqZaS.s:459: Error: constant value required
/tmp/ccZHqZaS.s:460: Error: constant value required
/tmp/ccZHqZaS.s:460: Error: constant value required
/tmp/ccZHqZaS.s:461: Error: constant value required
/tmp/ccZHqZaS.s:461: Error: constant value required
/tmp/ccZHqZaS.s:462: Error: constant value required
/tmp/ccZHqZaS.s:462: Error: constant value required
/tmp/ccZHqZaS.s:463: Error: constant value required
/tmp/ccZHqZaS.s:463: Error: constant value required
/tmp/ccZHqZaS.s:464: Error: constant value required
/tmp/ccZHqZaS.s:464: Error: constant value required
/tmp/ccZHqZaS.s:465: Error: constant value required
/tmp/ccZHqZaS.s:465: Error: constant value required
/tmp/ccZHqZaS.s:466: Error: constant value required
/tmp/ccZHqZaS.s:466: Error: constant value required
/tmp/ccZHqZaS.s:467: Error: constant value required
/tmp/ccZHqZaS.s:467: Error: constant value required
/tmp/ccZHqZaS.s:468: Error: constant value required
/tmp/ccZHqZaS.s:468: Error: constant value required
/tmp/ccZHqZaS.s:469: Error: constant value required
/tmp/ccZHqZaS.s:469: Error: constant value required
/tmp/ccZHqZaS.s:470: Error: constant value required
/tmp/ccZHqZaS.s:470: Error: constant value required
/tmp/ccZHqZaS.s:475: Error: constant value required
/tmp/ccZHqZaS.s:475: Error: constant value required
/tmp/ccZHqZaS.s:488: Error: constant value required
/tmp/ccZHqZaS.s:488: Error: constant value required
lto-wrapper: fatal error: /usr/bin/avr-gcc returned 1 exit status
compilation terminated.
/usr/lib/gcc/avr/5.4.0/../../../avr/bin/ld: error: lto-wrapper failed
collect2: error: ld returned 1 exit status
exit status 1
Error compiling for board Arduino Mega or Mega 2560.
```

dhansel, 2023-11-08:
It looks like Arduino IDE version 1.8.19 on Linux uses an older gcc (version 5.4.0) which appears to have issues with the way ASM macros are used in ArduinoFDC.cpp.

I recommend using the new Arduino IDE version 2.2.1 which comes with a newer gcc (version 7.3.0) and can compile ArduinoFDC without errors.

On Windows both versions of the Arduino IDE com with gcc 7.3.0 so there is no issue on that platform.

thiago1255, 2023-11-09:
Use the new IDE make it works ! thank you !

Closed 2023-11-09.

Thread 14 (2024-04-09):

problem

popunia1, 2024-04-09:
Hi, I have a problem. I decided to connect my 5.25 floppy disk drive to the computer in this way, connected all the wires, connected the adruino nano to the computer, started downloading the sketch and an error appeared: "

avr-g++: error: {build.define0}: No such file or directory
avr-g++: error: {build.define1}: No such file or directory
avr-gcc: error: {build.define0}: No such file or directory
avr-gcc: error: {build.define1}: No such file or directory
avr-g++: error: {build.define0}: No such file or directory
avr-g++: error: {build.define1}: No such file or directory
avr-g++: error: {build.define0}: No such file or directory
avr-g++: error: {build.define1}: No such file or directory
avr-g++: error: {build.define0}: No such file or directory
avr-g++: error: {build.define1}: No such file or directory

exit status 1

Compilation error: exit status 1

". I'm not good at this and I'd appreciate your help.

dhansel, 2024-04-10:
Does the "blink" example compile? (Select File->Examples->01. Basics->Blink, then try to compile).
Also make sure to select the Arduino Nano as the board (in the "Tools" menu).

I have never seen these errors before. It looks like something is wrong with your Arduino IDE installation.
Are you on Windows? If so, I would recommend re-installing the Arduino IDE.

popunia1, 2024-04-10:
as a result, I installed the old version of IDE and everything worked out, thanks

Closed 2024-04-10.

Thread 15 (2024-06-23):

Migtation to stm32

TEN1HC, 2024-06-23:
[FDD_Stm32_v03.zip](https://github.com/user-attachments/files/15944252/FDD_Stm32_v03.zip)
Im trying to migrate this lib to Stm32f103c8t6.
Using timer1 for input capture
Using timer3 for some index/pusle ..,check
Using timer2 for pwm out write data (not implemented yet)

Failure detected as f_open method => DISK_ERROR

So many thing to do and it still not work.
Could you help to check?

dhansel, 2024-06-23:
I had a look at your low-level reading code (function read_data in FDD.cpp), and it looks you don't quite have
a good grasp yet of how the MFM encoding on floppy disks works. It's not as simple as "short time between pulses=0"
and "long time=1". The read_data() function in my code does quite a bit more than that (but of course it's very specific
to the Atmega328p and therefore can't be used for STM32). I recommend reading up on the basics of MFM encoding
and how to read floppy disks. There's some good information here:
https://www.5volts.ch/posts/mfmreader
https://www.hermannseib.com/documents/floppy.pdf

Apart from that you have to be sure to get your timing right. There may only be 2us of time between two
pulses received from the drive. I don't know anything about STM32 but you may want to double-check
the interrupt latency since your CaptureCallback function relies on interrupts. If the latency is too high you
may miss some pulses. Also make sure that other interrupts don't get in the way,

This is definitely not an easy project to port to a different platform. It took me months of working with
an Oscilloscope and Logic Analyzer to get the timings right on the Atmega328p. I would suggest testing
at a lower level than the f_open() call. When I developed ArduinoFDC I started with the low-level disk monitor
that allowed me to just read (and write) data to one sector. I started with a known-good formatted disk
and used a program such as OmniFlop on a PC to get the expected content of a sector. Then on ArduinoFDC
read that same sector to see what I got. Use an Oscilloscope to really look at the timing, the points when
you read the data bits etc. Debug, rinse and repeat. It's a long process but very rewarding once you finally
get it right (and you'll learn a lot about debugging tools and techniques along the way).

Good luck!

TEN1HC, 2024-06-23:
Great to receive reply from you.
I realize that Im so naive when just give a simple pulse read method like that.
Thank you very much for the reference documentation.

Thread 16 (2025-01-19):

Pull-up documentation mismatch

geby, 2025-01-19:
In Readme.md in the wiring section you have "note 2" about 1k resistor as pull-up on ReadData signal only.

However in shield schematics you have pull-up resistor on Index signal too, and both resistors are 10k for UNO, or 1k for Mega.

So, what is correct resistor value? Should not be "note 2" on Index signal too?

Thank you!

dhansel, 2025-01-20:
Thanks for pointing this out. The correct resistor value is 1k, I have updated the schematic.

The 1k resistor on the Index signal is not really necessary, I just added it to the shield out of extra caution. The ArduinoFDC library activates the internal pull-up resistors in the Uno for both the ReadData and Index signal. However, those pull-ups are pretty weak and for a fast-changing signal like ReadData it may be too weak to pull it up quickly enough for the next pulse.

The Index signal is the only other input signal that also changes frequently, albeit not nearly as quickly as the ReadData signal. So I decided to put a pull-up resistor onto the shield just in case it ever became a problem. However, I have never had any issues without the Index pull-up resistor. For this signal the internal Arduino Uno pull-up is sufficient. You can populate the resistor or leave it out, it shouldn't make any difference.

Thread 18 (2025-02-09):

disk type command error

MetalBasket423, 2025-02-09:
whenever i type "disktype ArduinoFDC::DT_3_HD" into the "command line" it always defaults to 5.25 inch double density drive instead of 3.5 inch high density drive

MetalBasket423, 2025-02-10:
alright thank you

Closed 2025-02-10.

Thread 19 (2025-07-18):

Error: drive not ready and motor continually spinning when a floppy disk is inserted

Xcold0, 2025-07-18:
When I put a floppy disk in the drive and try to format or read a floppy disk the error drive not ready comes up. I've checked the wiring and that is correct and I've tried a different floppy disk the problem is still there.

Also the error drive not ready also appears when I try to do anything with the disk when on is not inserted which has made me think this might be an issue with the drive itself, though I am not sure.

This is on a 3.5 HD drive. The disks used are unformatted disks.

montyleib, 2025-07-19:
Assuming that you found your problem, would you like to share your solution in case someone else runs into it?

Xcold0, 2025-07-20:
It was improper grounding that was the issue one of the GND pins didn't go in all the way

Closed 2025-07-19.
