dhansel/ArduinoFDC/ArduinoFDCShieldSchematic.pdf

# ARDUINO UNO

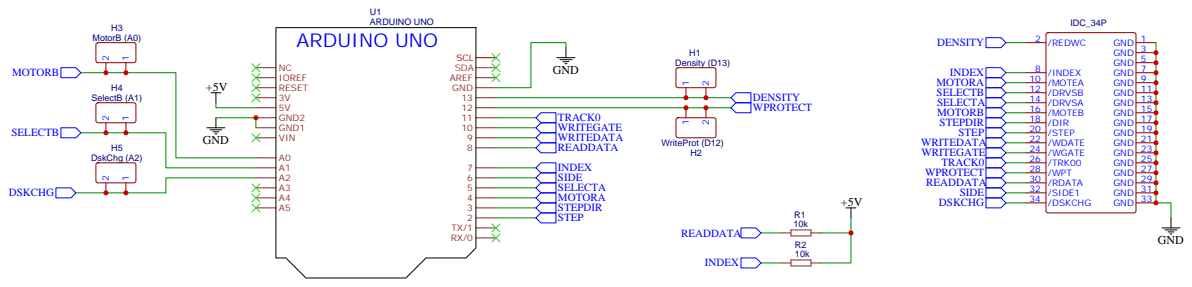
[picture p6: page 1]
