dhansel/ArduinoFDC/ArduinoFDCMegaShieldSchematic.pdf

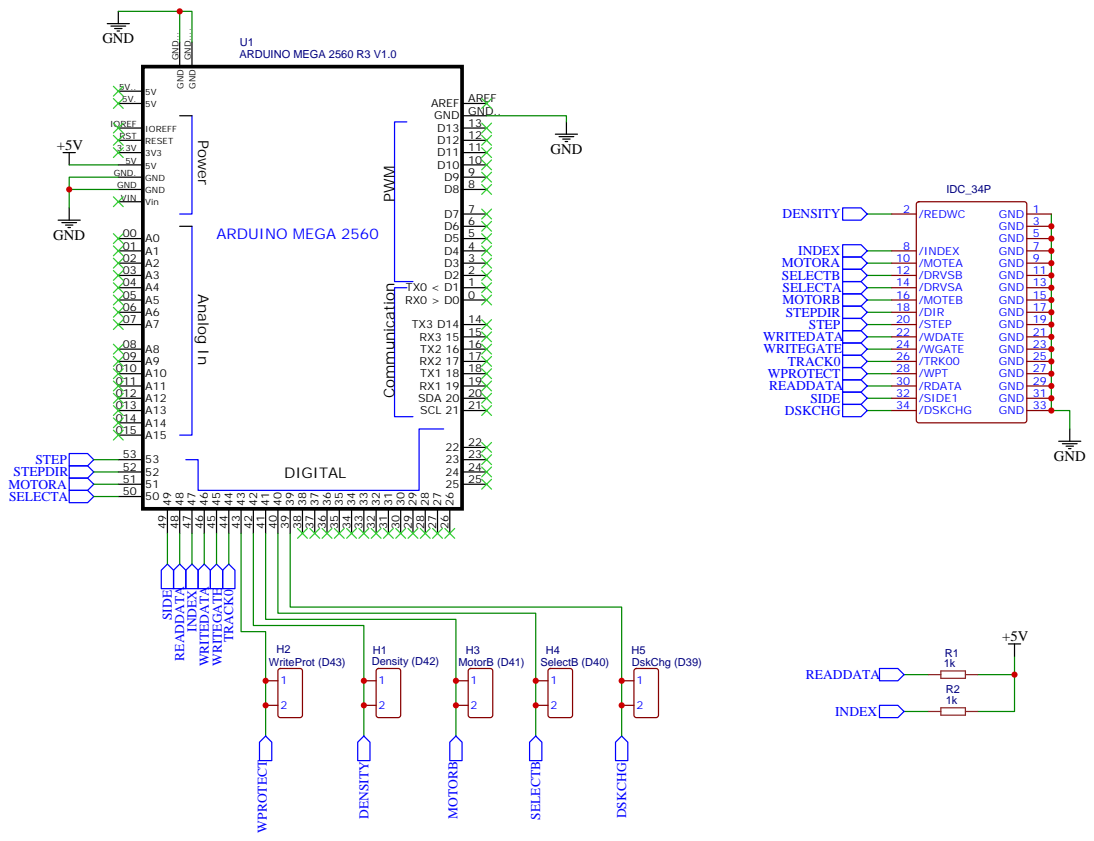
[picture p7: page 1]
