dhansel/ArduinoFDC/(commit log)

2020-11-01 Support two drives (A/B), provide error return codes for main functions.
    [ArduinoFDC.cpp, ArduinoFDC.h, ArduinoFDC.ino]
2021-04-23 Fixed issues with 5.25" DD disks in HD drive. Added function haveDisk().
    [ArduinoFDC.cpp, ArduinoFDC.h]
2021-04-29 Fixed issue in monitor data buffer was overwritten with user command. Keep motor running during ArduiDOS 'write' command.
    [ArduinoFDC.ino]
2021-04-29 Support Arduino MEGA
2021-04-30 - pass temporary buffer into formatDisk() to avoid allocating stack memory - fixed reading index signal when determining end-of-track during format
    [ArduinoFDC.cpp, ArduinoFDC.h, ArduinoFDC.ino]
2021-05-04 Fixed sector check in monitor 'r' command
    [ArduinoFDC.ino]
2021-05-07 Added forward declaration for print_ff_error which reportedly can fix a strange compile error by some Arduino versions (not able to reproduce the error here).
    [ArduinoFDC.ino]
2021-05-07 Fixed size of "geometry" array and added some debug output
    [ArduinoFDC.cpp]
2021-05-08 Reorganzied some code, improved robustness for some errors
    [ArduinoFDC.cpp, ArduinoFDC.h, ArduinoFDC.ino]
2021-05-09 Some more comment fixes
    [ArduinoFDC.cpp]
2021-05-10 Support Arduino Leonardo/Micro (Atmega32U4)
2021-05-11 Fixed a number of compiler warnings
    [ArduinoFDC.cpp, ArduinoFDC.h, ArduinoFDC.ino, diskio.cpp, diskio.h, ff.c]
2021-05-14 Fixed some more compiler warnings
    [ArduinoFDC.cpp, ArduinoFDC.ino]
2024-12-17 Added schematics for shields
